steamroller16/lightpipe/README.md

lightpipe
=========
Test commit - Sam
Test commit - Adam!
