steamroller16/lightpipe/manufacturing/laser_cutter_file_rev2.pdf

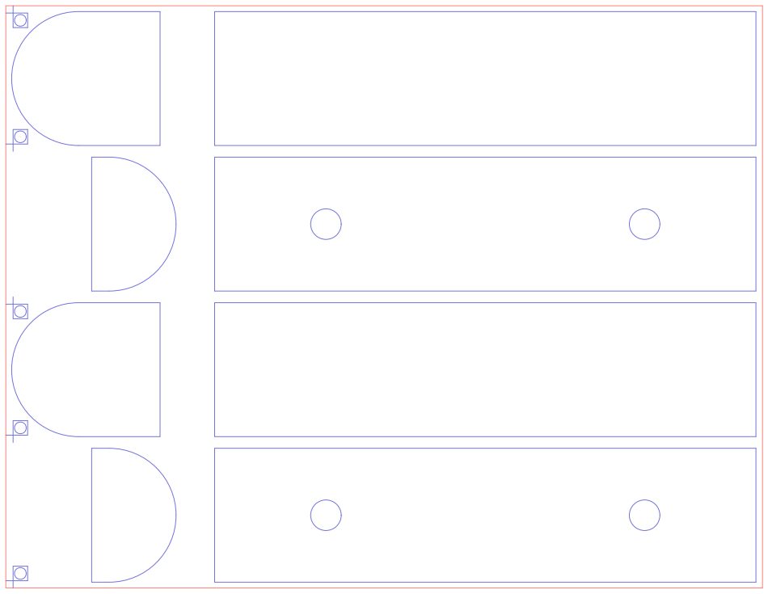
[picture p1: figure]
