steamroller16/lightpipe/assembly/assembly_merged_raster.pdf

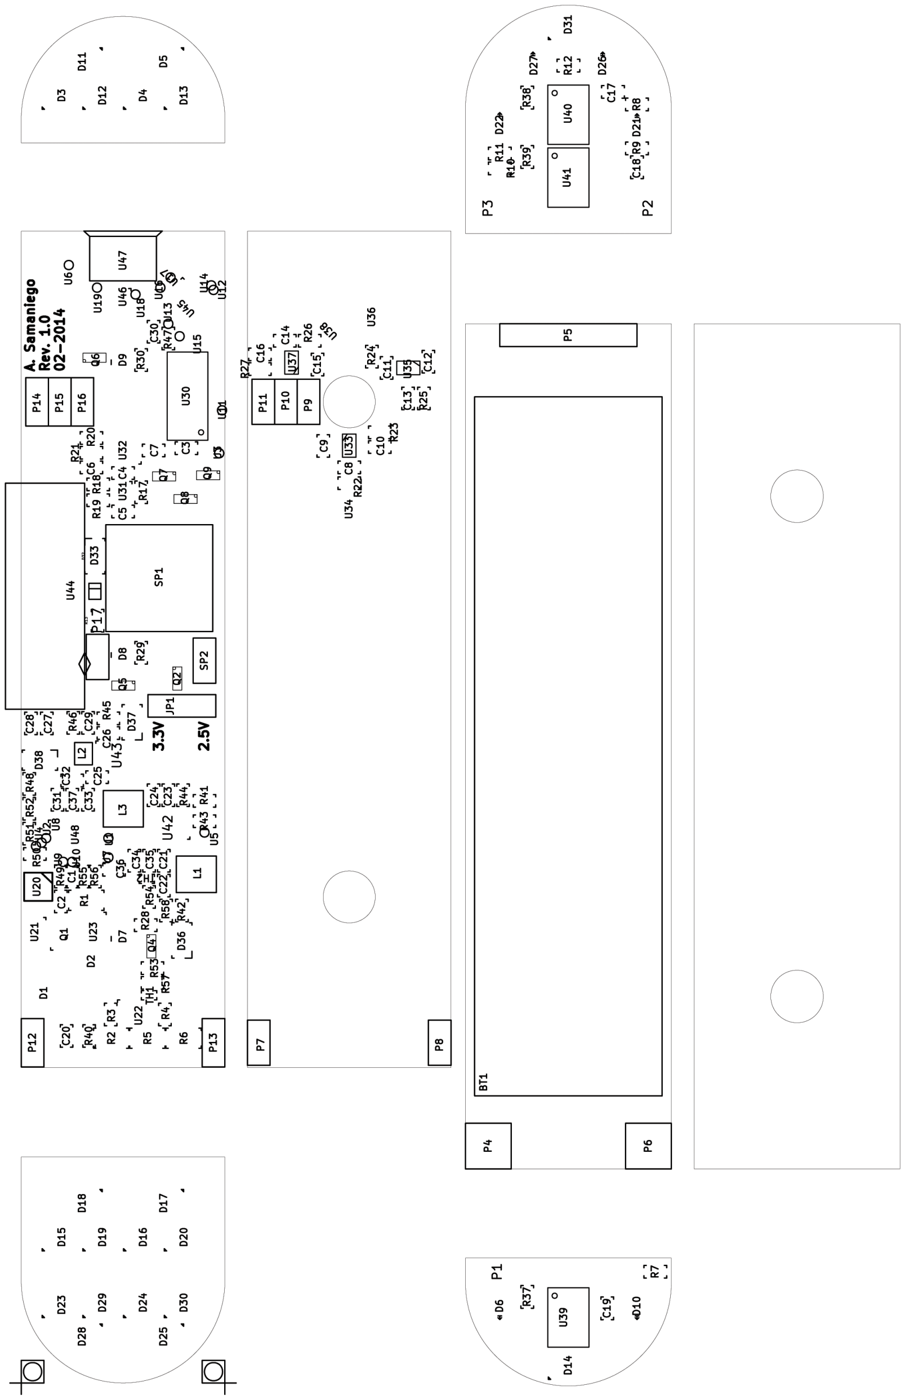
[picture p2: page 1]
