steamroller16/lightpipe/manufacturing/bike_light_PANEL_Laser_Cuts.pdf

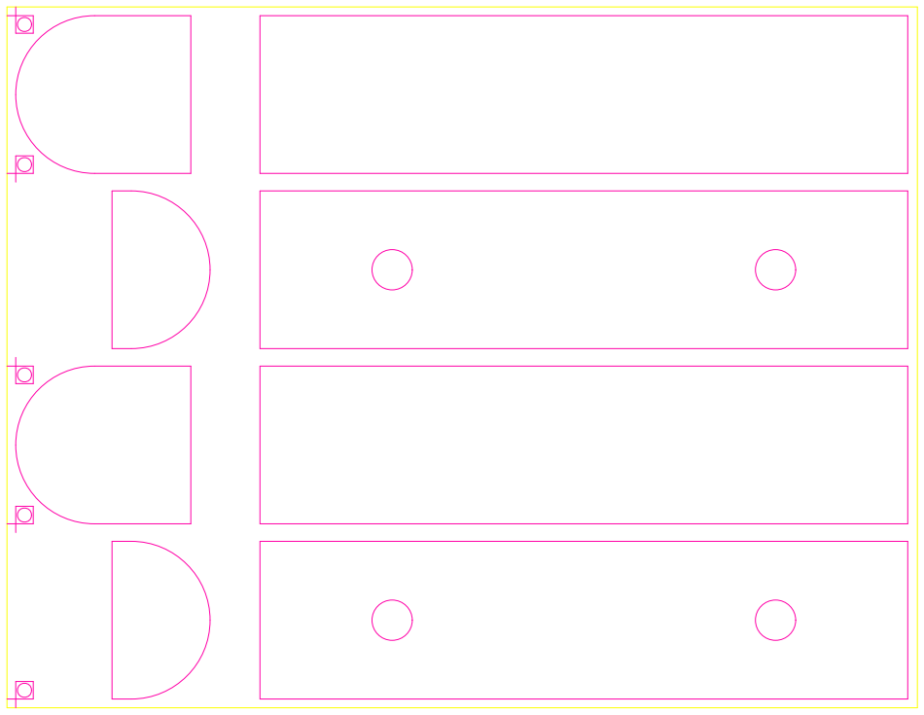
[picture p3: figure]
