steamroller16/lightpipe/manufacturing/preview_layer_1.png

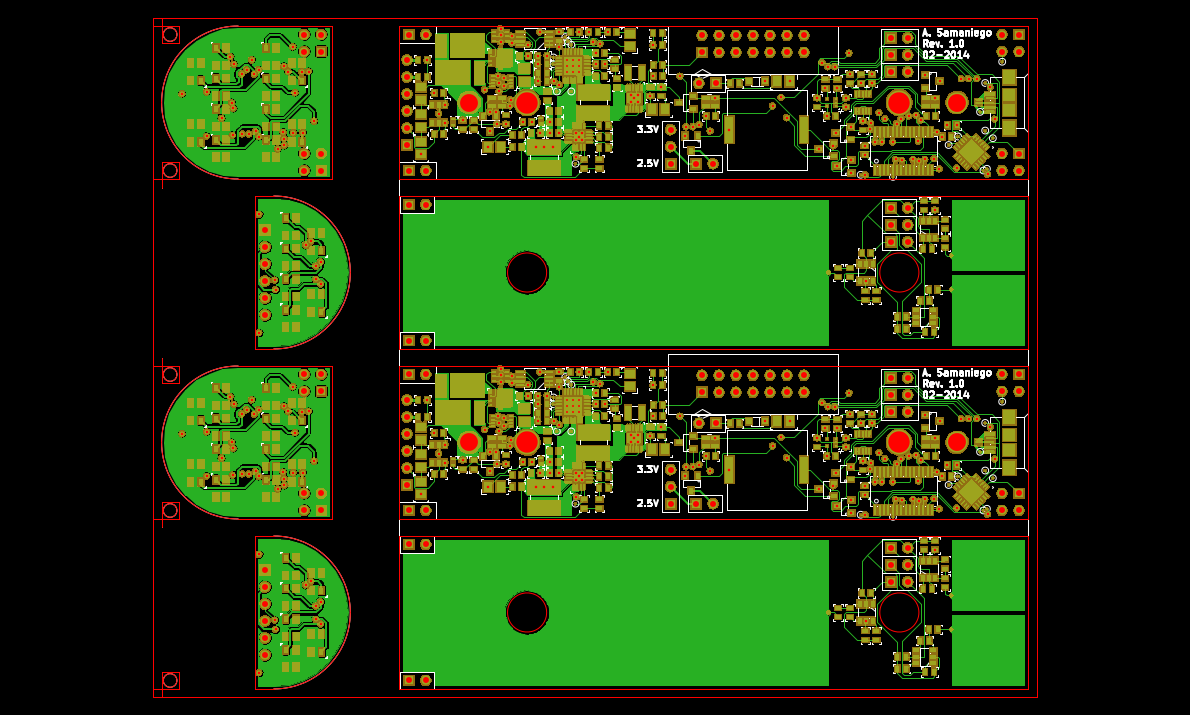
manufacturing/preview_layer_1.png
