steamroller16/lightpipe/manufacturing/preview_layer_2.png

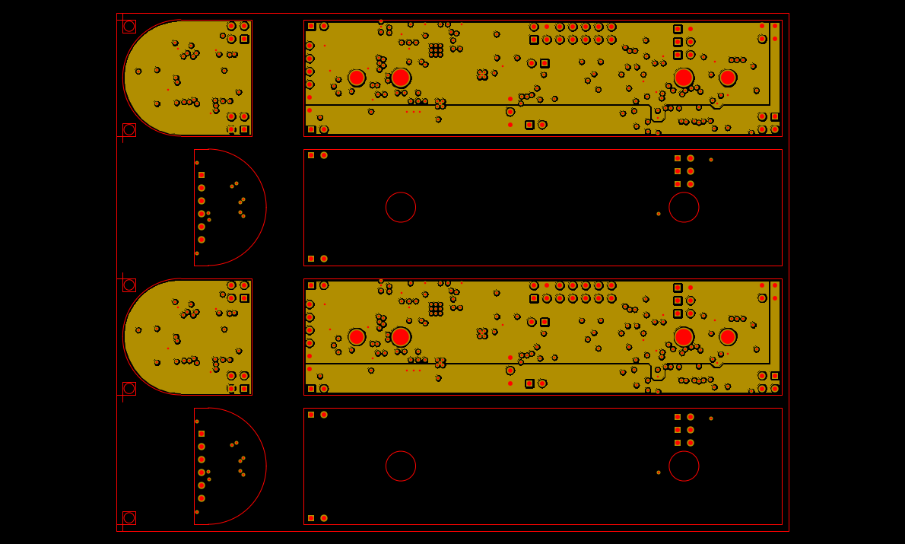
manufacturing/preview_layer_2.png
