steamroller16/lightpipe/manufacturing/preview_layer_3.png

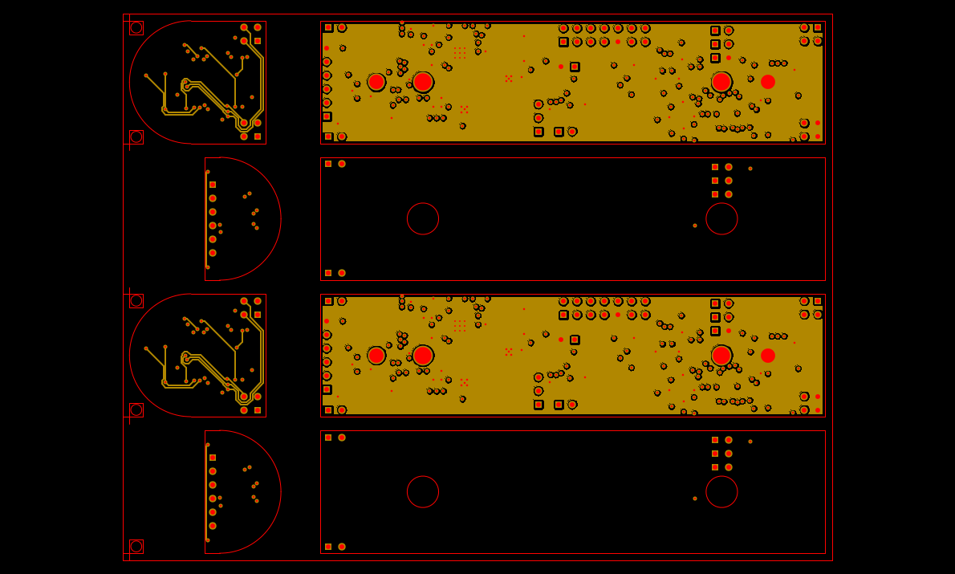
manufacturing/preview_layer_3.png
