steamroller16/lightpipe/manufacturing/preview_layer_4.png

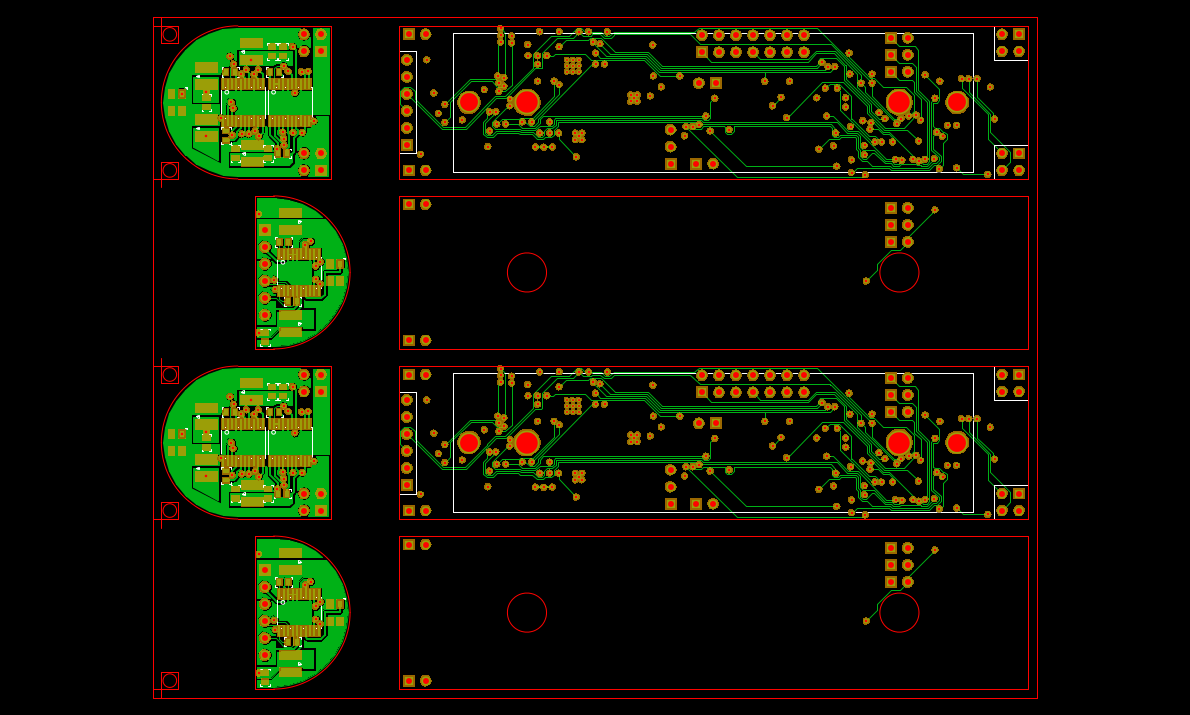
manufacturing/preview_layer_4.png
