steamroller16/lightpipe/assembly/bike_light_sch.pdf

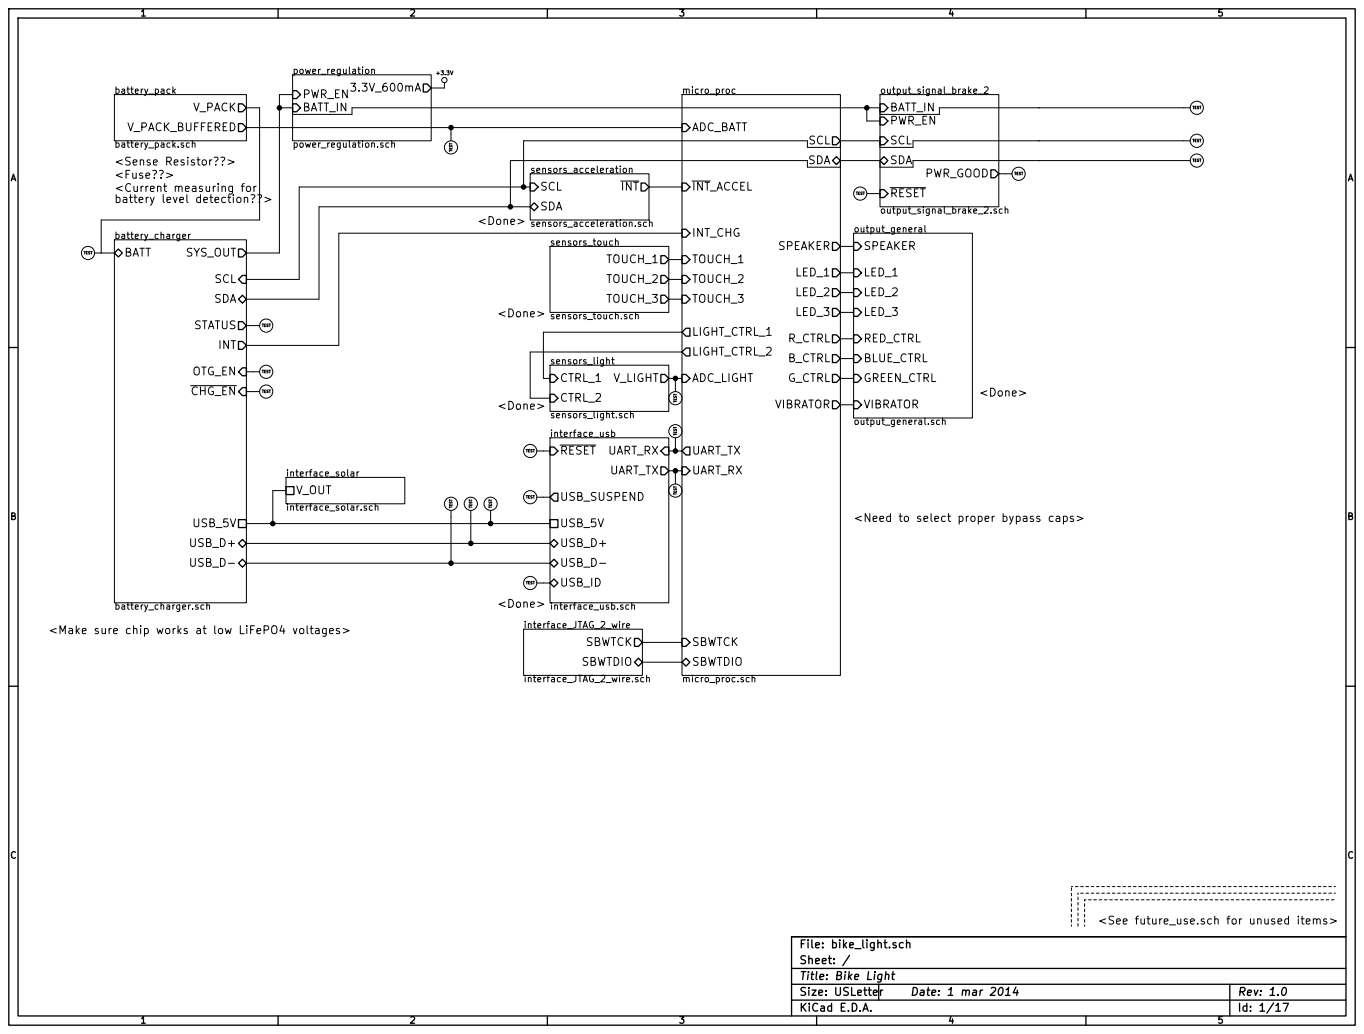
[picture p8: page 1]

<Need to select proper bypass caps>

<Make sure chip works at low LiFePO4 voltages>

<See future_use.sch for unused items>

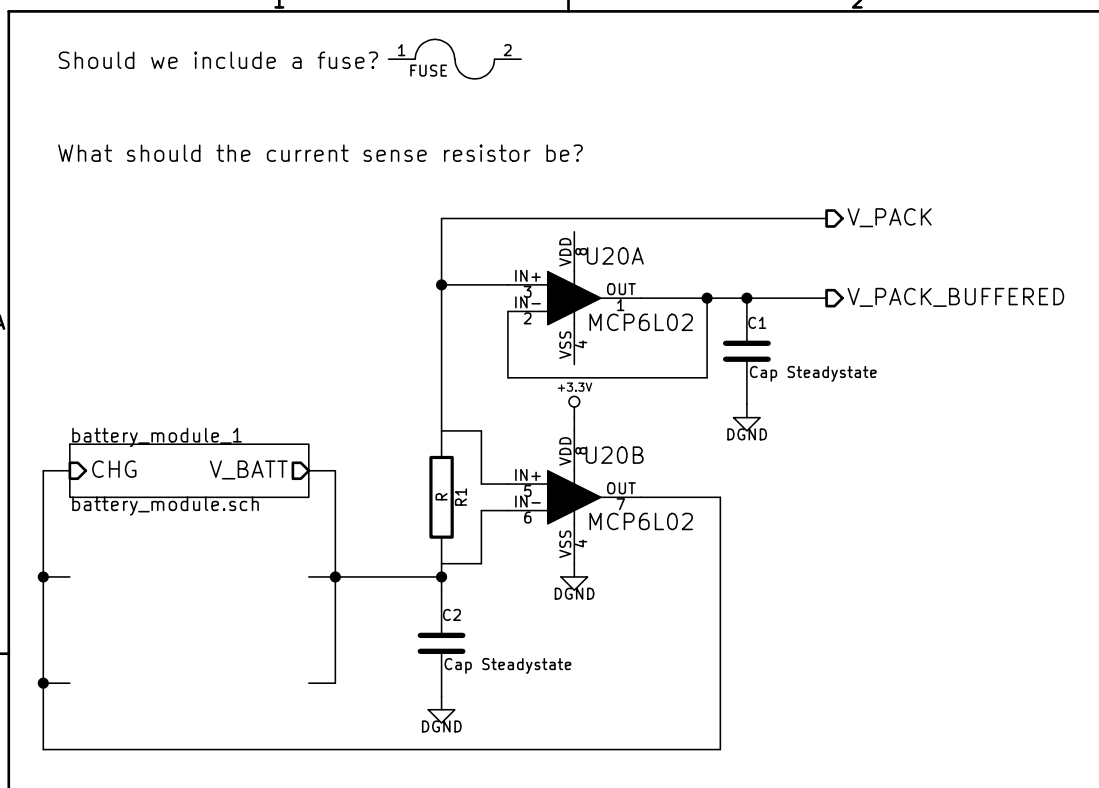
[picture p9: page 2]

Id: 2/17 Title: File: battery_pack.sch
Sheet: /battery_pack/

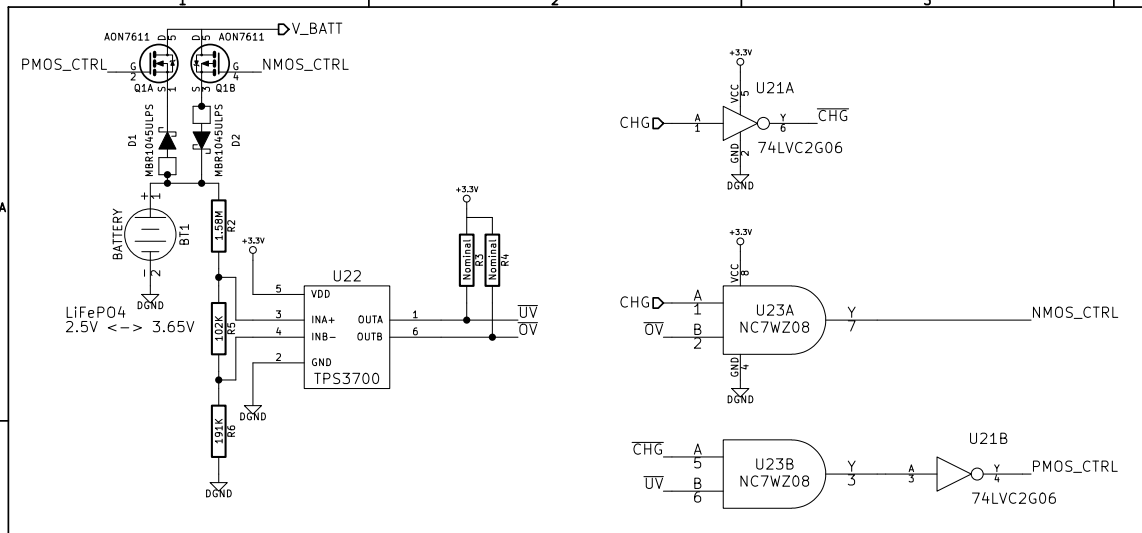
[picture p10: page 3]

Id: 3/17 Title: File: battery_module.sch
Sheet: /battery_pack/battery_module_1/

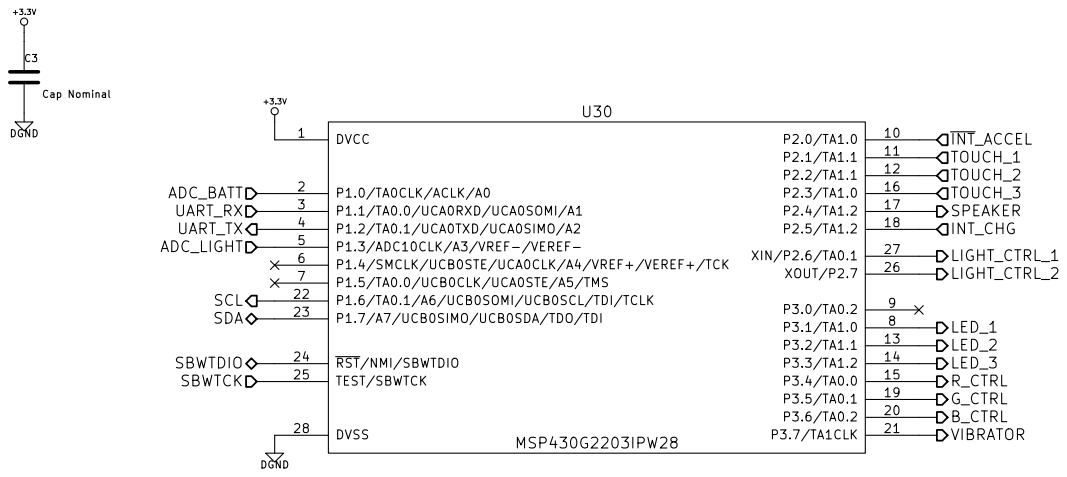
[picture p11: page 4]

Id: 4/17 Title: File: micro_proc.sch
Sheet: /micro_proc/

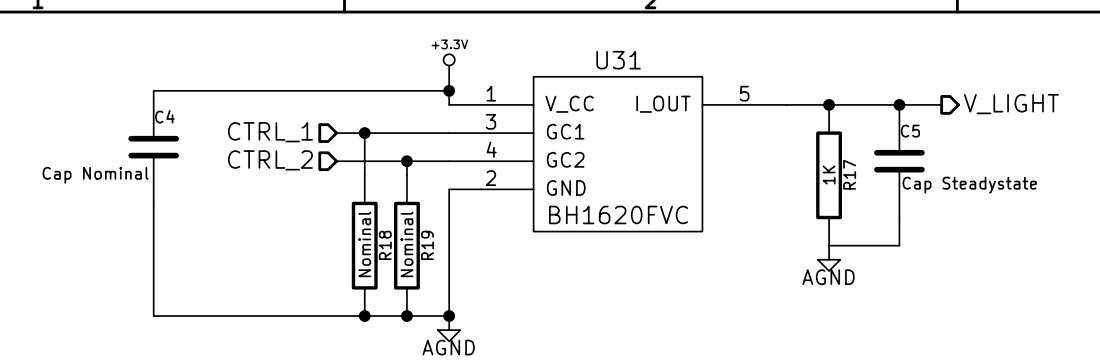
[picture p12: page 5]

Id: 5/17 Title: File: sensors_light.sch

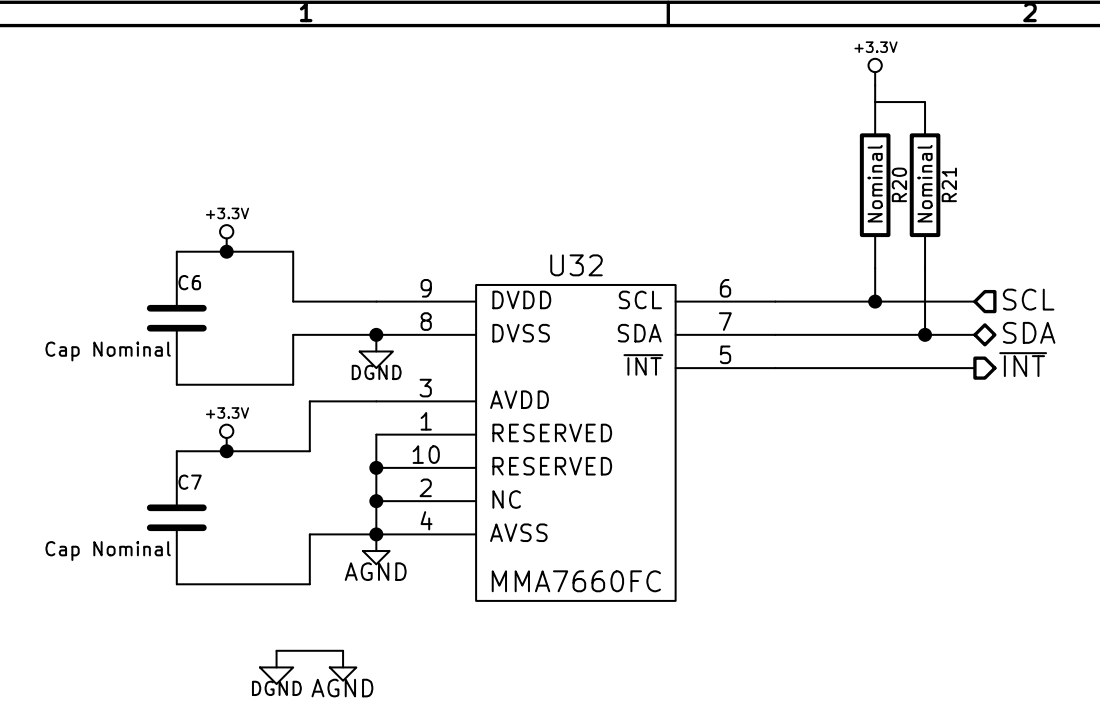
[picture p13: page 6]

Id: 6/17 Title: File: sensors_acceleration.sch
Sheet: /sensors_acceleration/

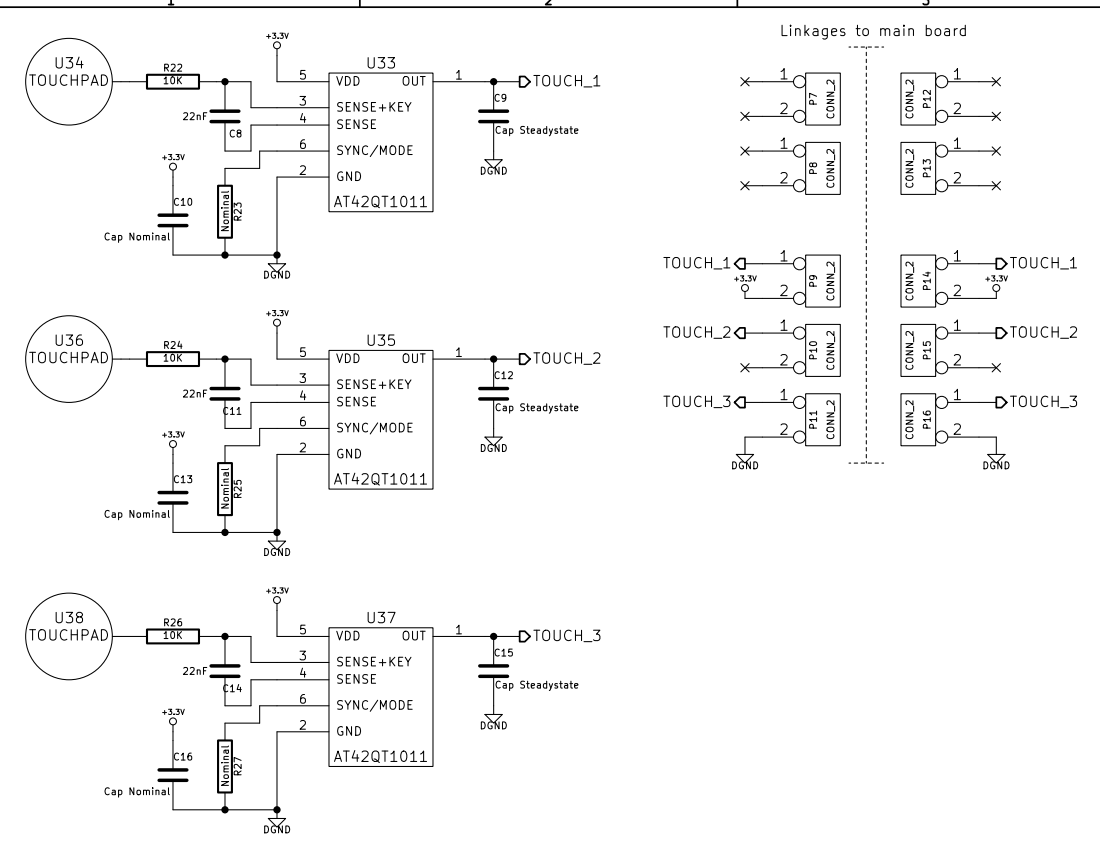
[picture p14: page 7]

Id: 7/17 Title: File: sensors_touch.sch
Sheet: /sensors_touch/

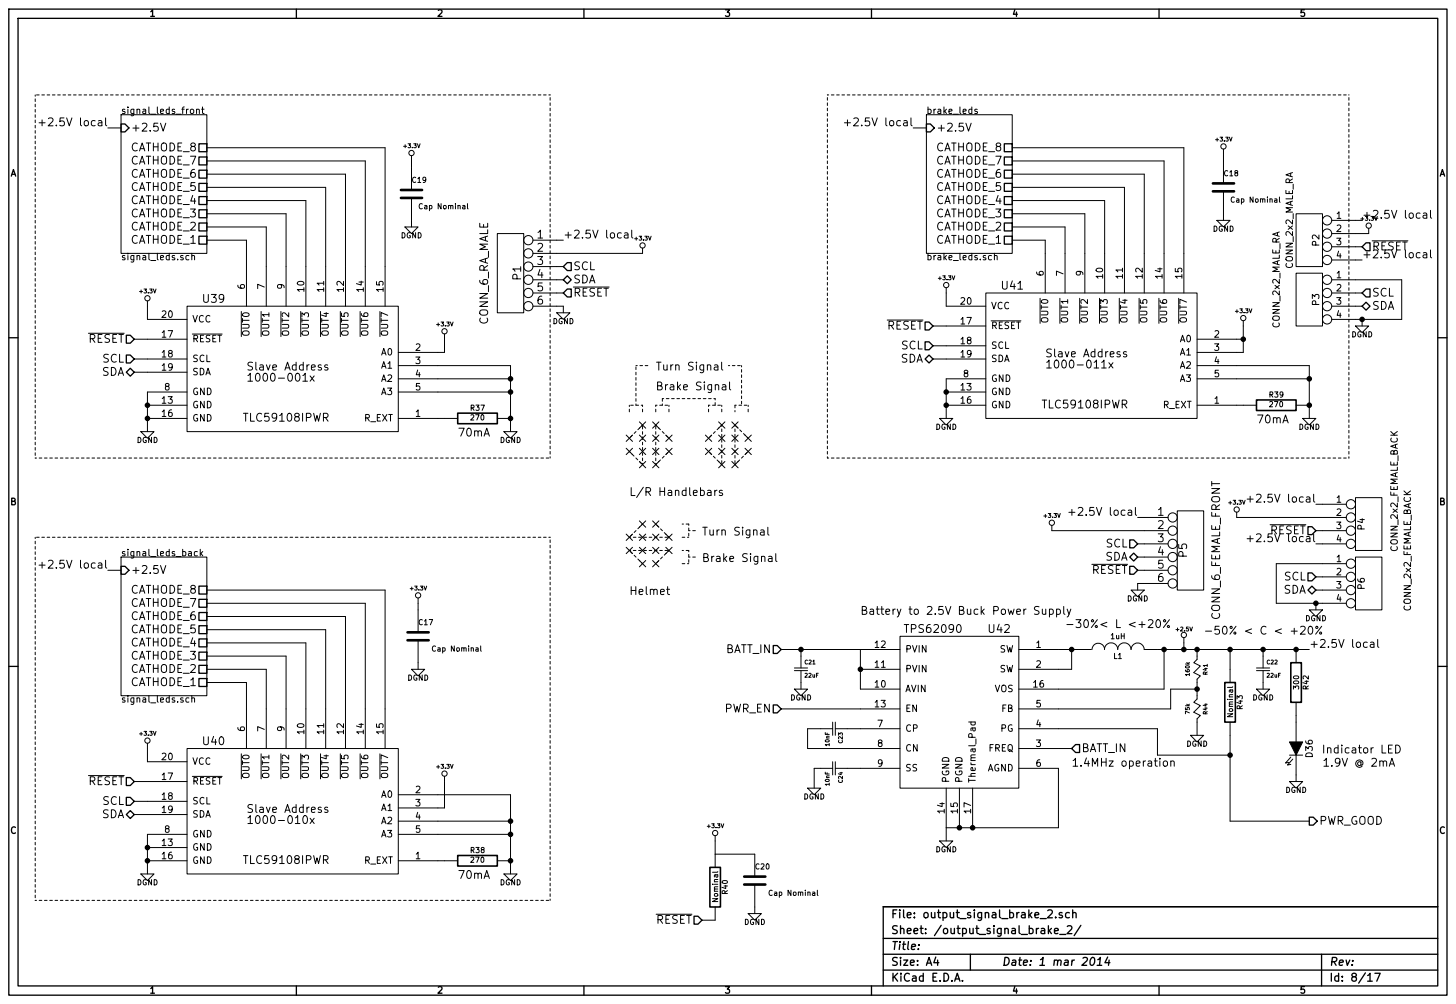
[picture p15: page 8]

9 OUT3 10 VCC 20 OUT4 11 OUT5 12 GND 13 OUT6 14 OUT7 15 GND 16 RESET 17 SCL 18 SDA 19 U41 TLC59108IPWR

9 OUT3 10 VCC 20 OUT4 11 OUT5 12 GND 13 OUT6 14 OUT7 15 GND 16 RESET 17 SCL 18 SDA 19 U39 TLC59108IPWR

+3.3VC17 Cap Nominal Slave Address 1000-010x RESET

9 OUT3 10 VCC 20 OUT4 11 OUT5 12 GND 13 OUT6 14 OUT7 15 GND 16 RESET 17 SCL 18 SDA 19 U40 TLC59108IPWR

Id: 8/17 Title: File: output_signal_brake_2.sch
Sheet: /output_signal_brake_2/

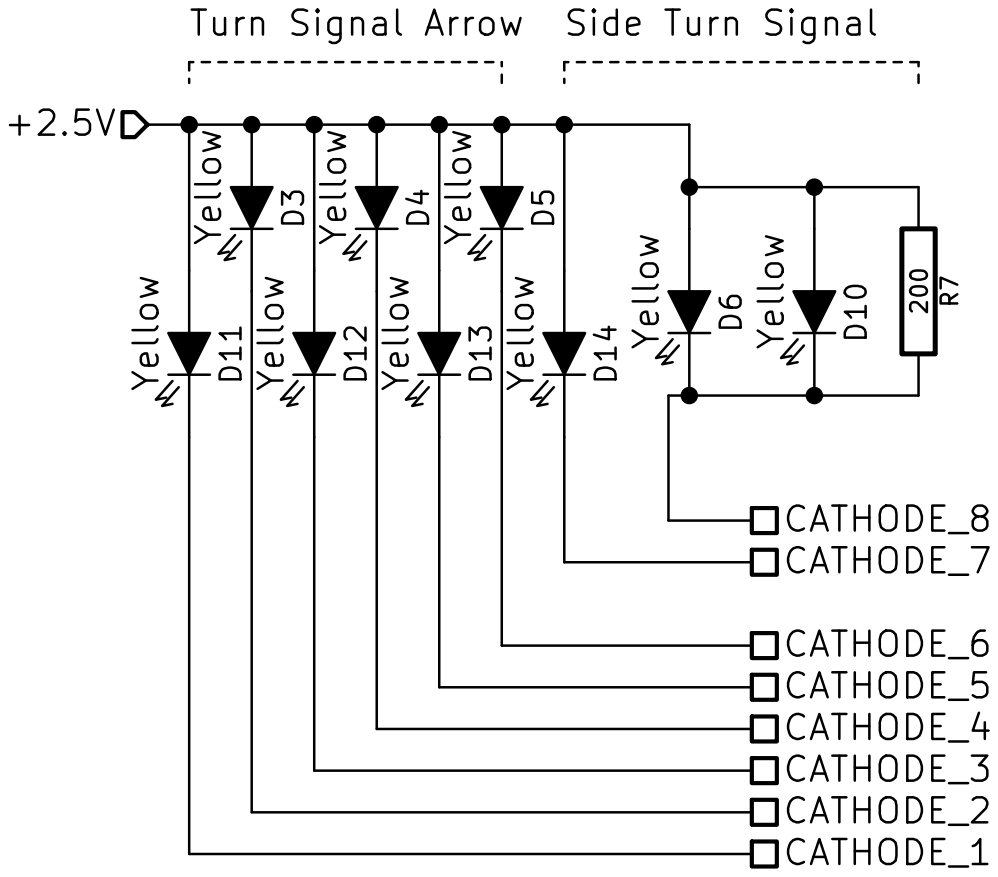
[picture p16: page 9]

Id: 9/17 Title: File: signal_leds.sch
Sheet: /output_signal_brake_2/signal_leds_front/

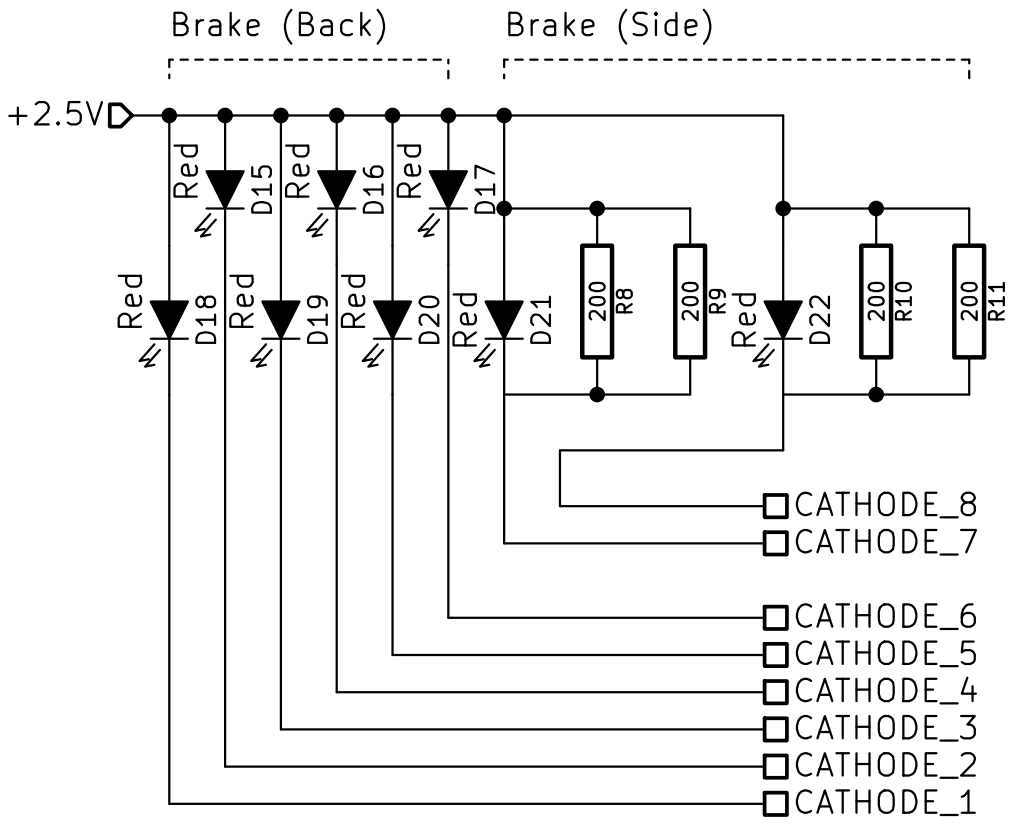
[picture p17: page 10]

Id: 10/17 Title: File: brake_leds.sch
Sheet: /output_signal_brake_2/brake_leds/

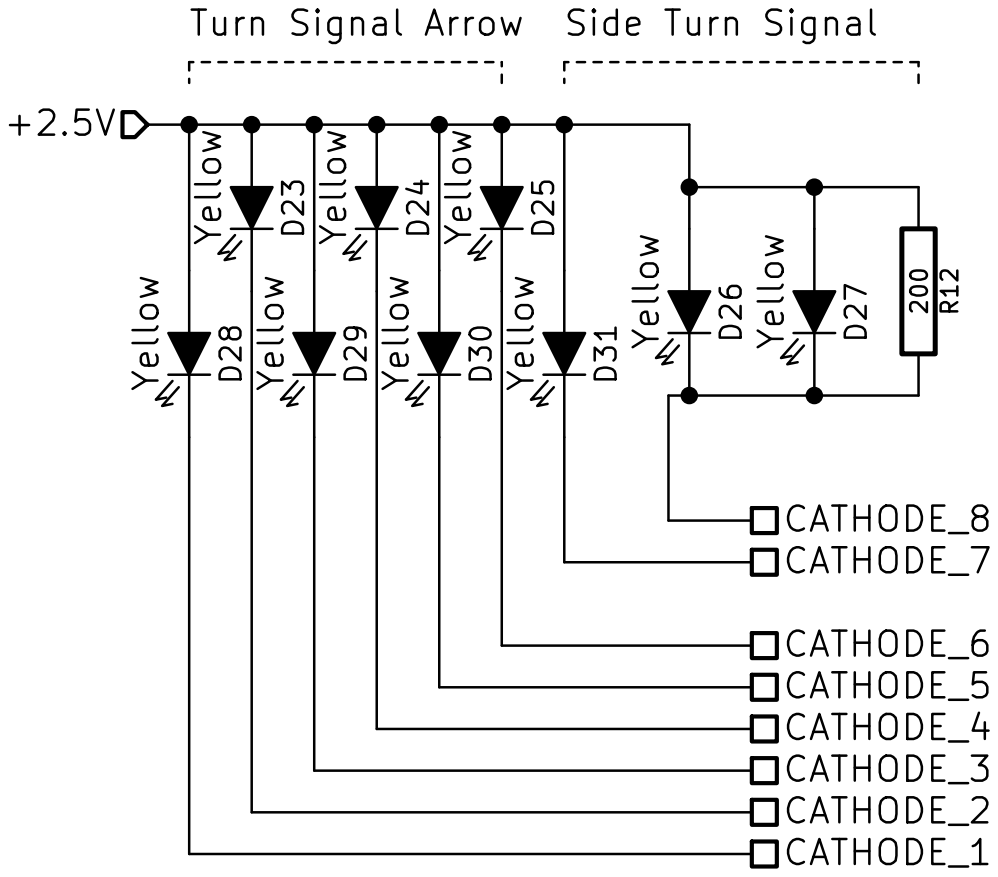
[picture p18: page 11]

Id: 11/17 Title: File: signal_leds.sch
Sheet: /output_signal_brake_2/signal_leds_back/

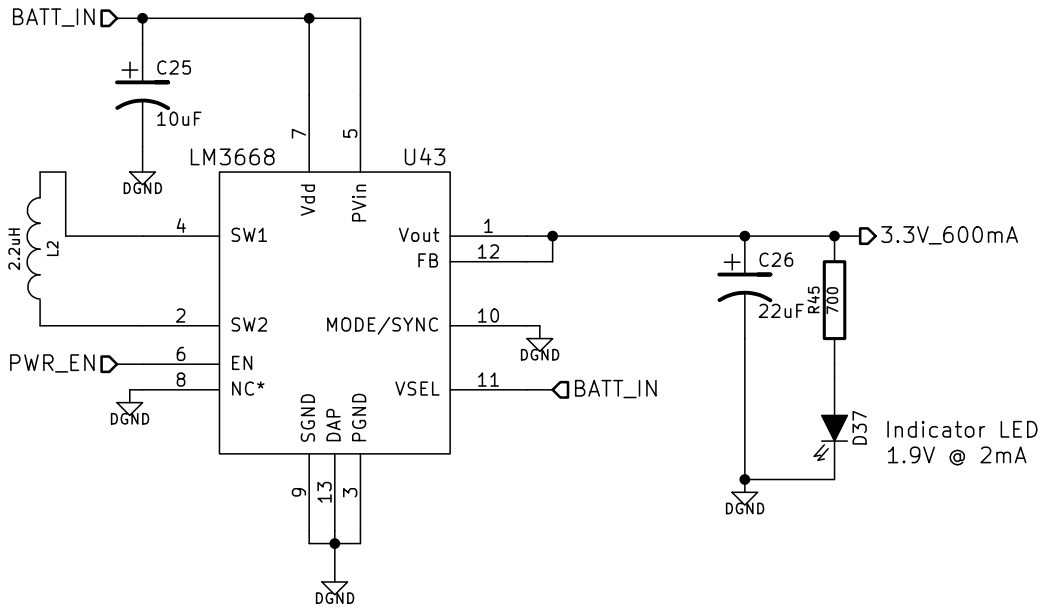
[picture p19: page 12]

9 MODE/SYNC 10 VSEL 11 FB 12 DAP 13 LM3668 U43 + C25

Id: 12/17 Title: File: power_regulation.sch

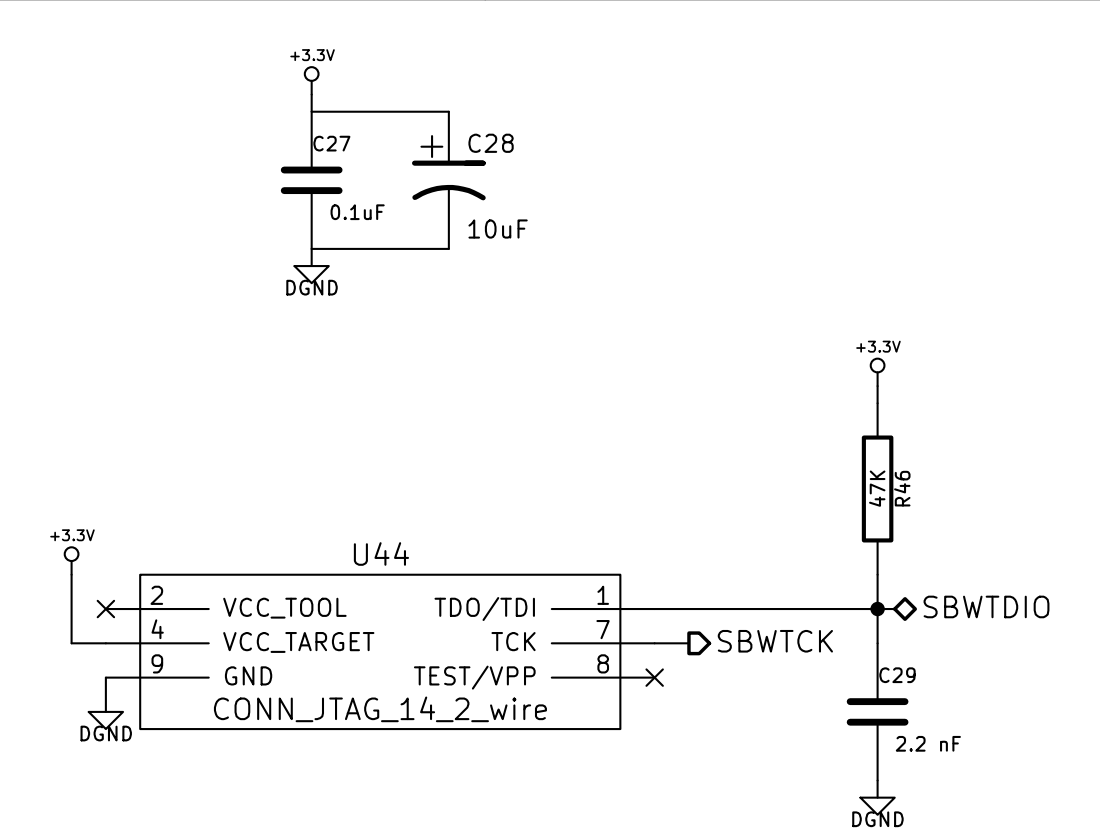
[picture p20: page 13]

Id: 13/17 Title: File: interface_JTAG_2_wire.sch
Sheet: /interface_JTAG_2_wire/

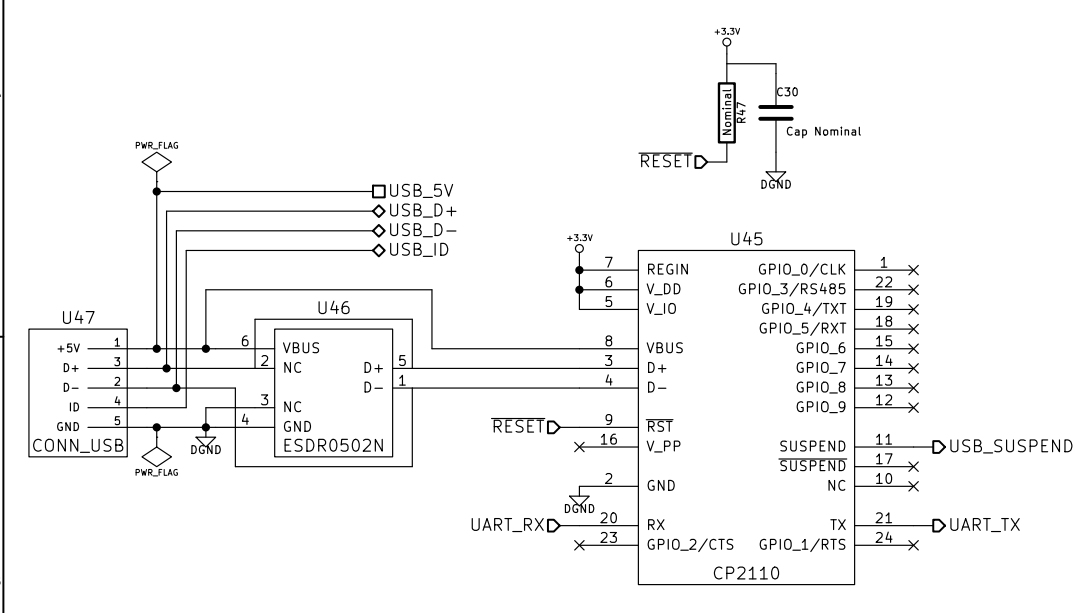
[picture p21: page 14]

Id: 14/17 Title: File: interface_usb.sch
Sheet: /interface_usb/

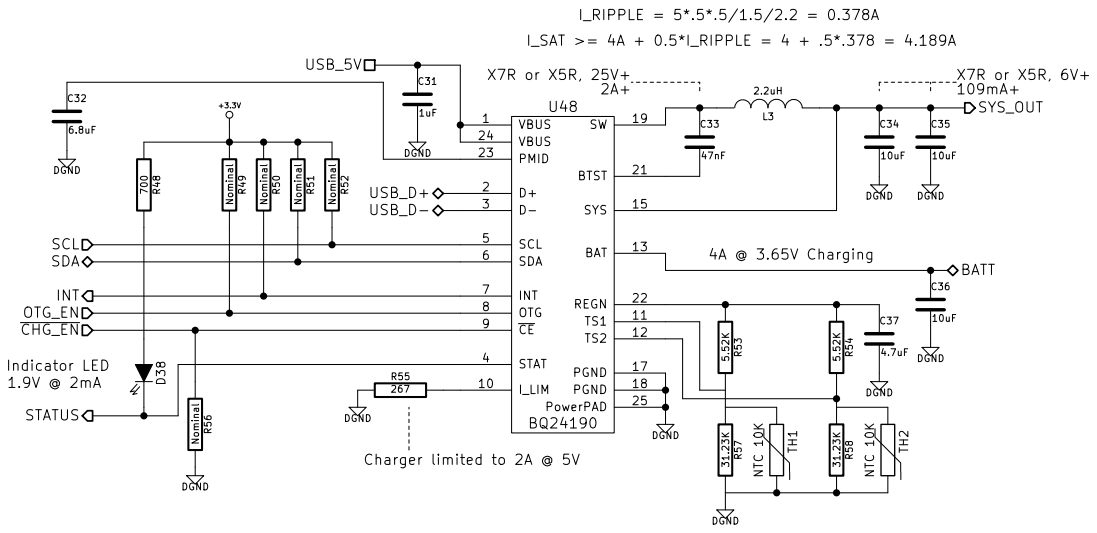
[picture p22: page 15]

Id: 15/17 Title: File: battery_charger.sch
Sheet: /battery_charger/

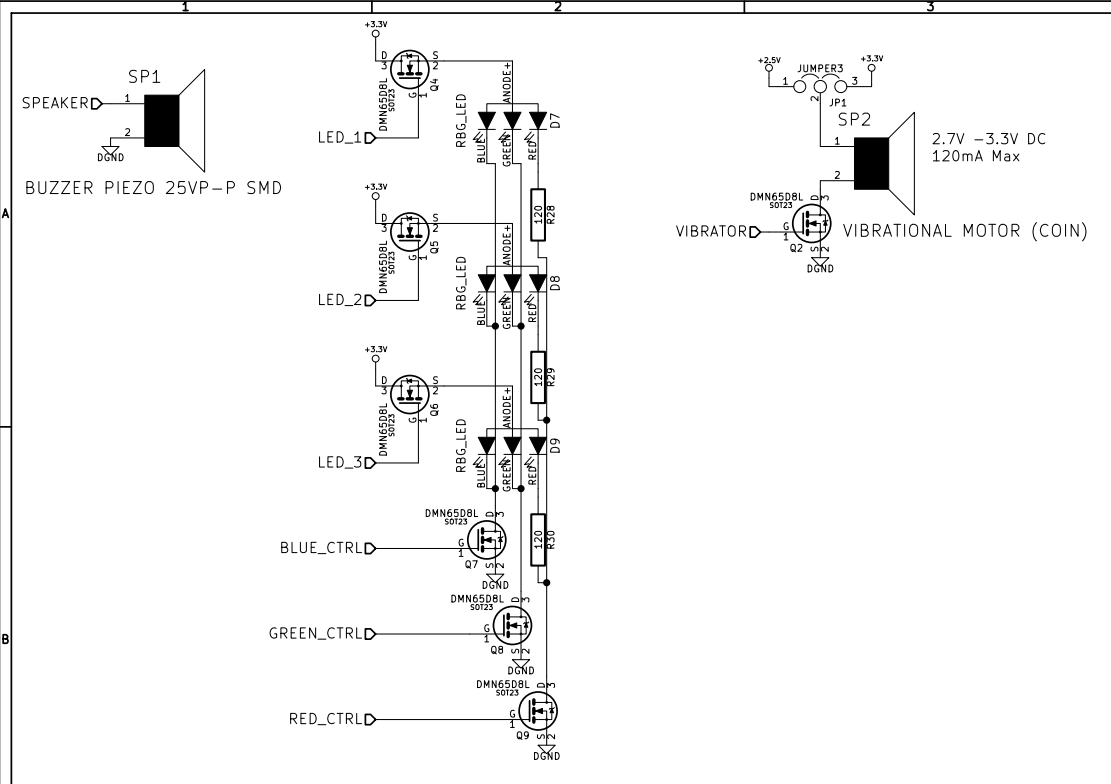
[picture p23: page 16]

3 Q2 DMN65D8L
VIBRATIONAL MOTOR (COIN) DGND

Id: 16/17 Title: File: output_general.sch
Sheet: /output_general/

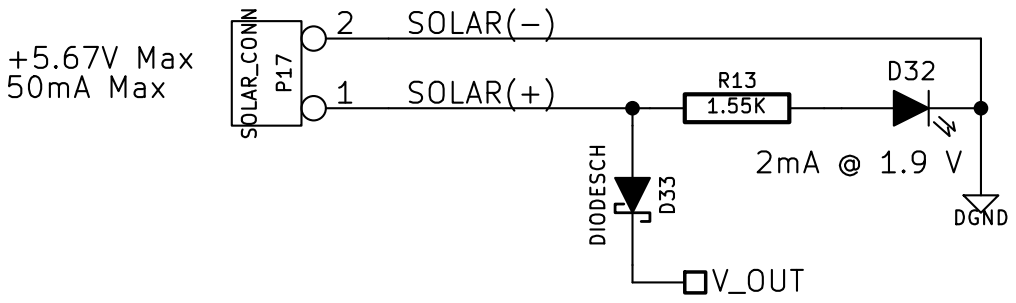
[picture p24: page 17]

Id: 17/17 Title: File: interface_solar.sch
Sheet: /interface_solar/
