steamroller16/lightpipe/assembly/assembly_bottom_vector.pdf

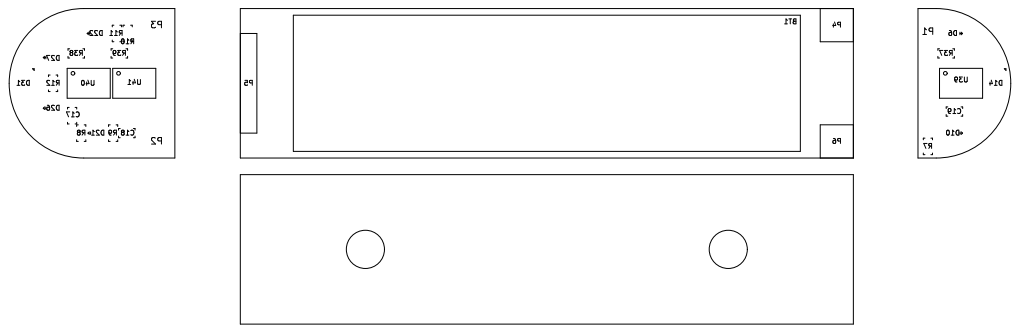
[picture p25: page 1]
