steamroller16/lightpipe/assembly/assembly_top_vector.pdf

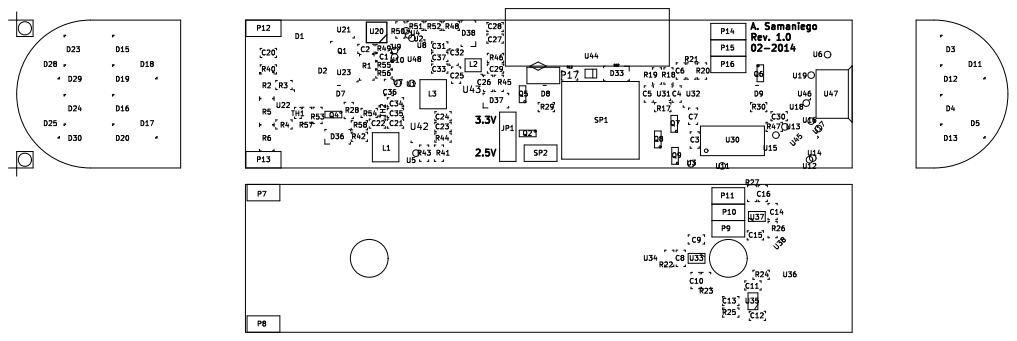
[picture p26: page 1]
