steamroller16/lightpipe/(list of files, drawings)

Other design files:
bike_light.dsn
