steamroller16/lightpipe/bike_light.kicad_pcb

## KiCad design bike_light.kicad_pcb (2014-06-01)

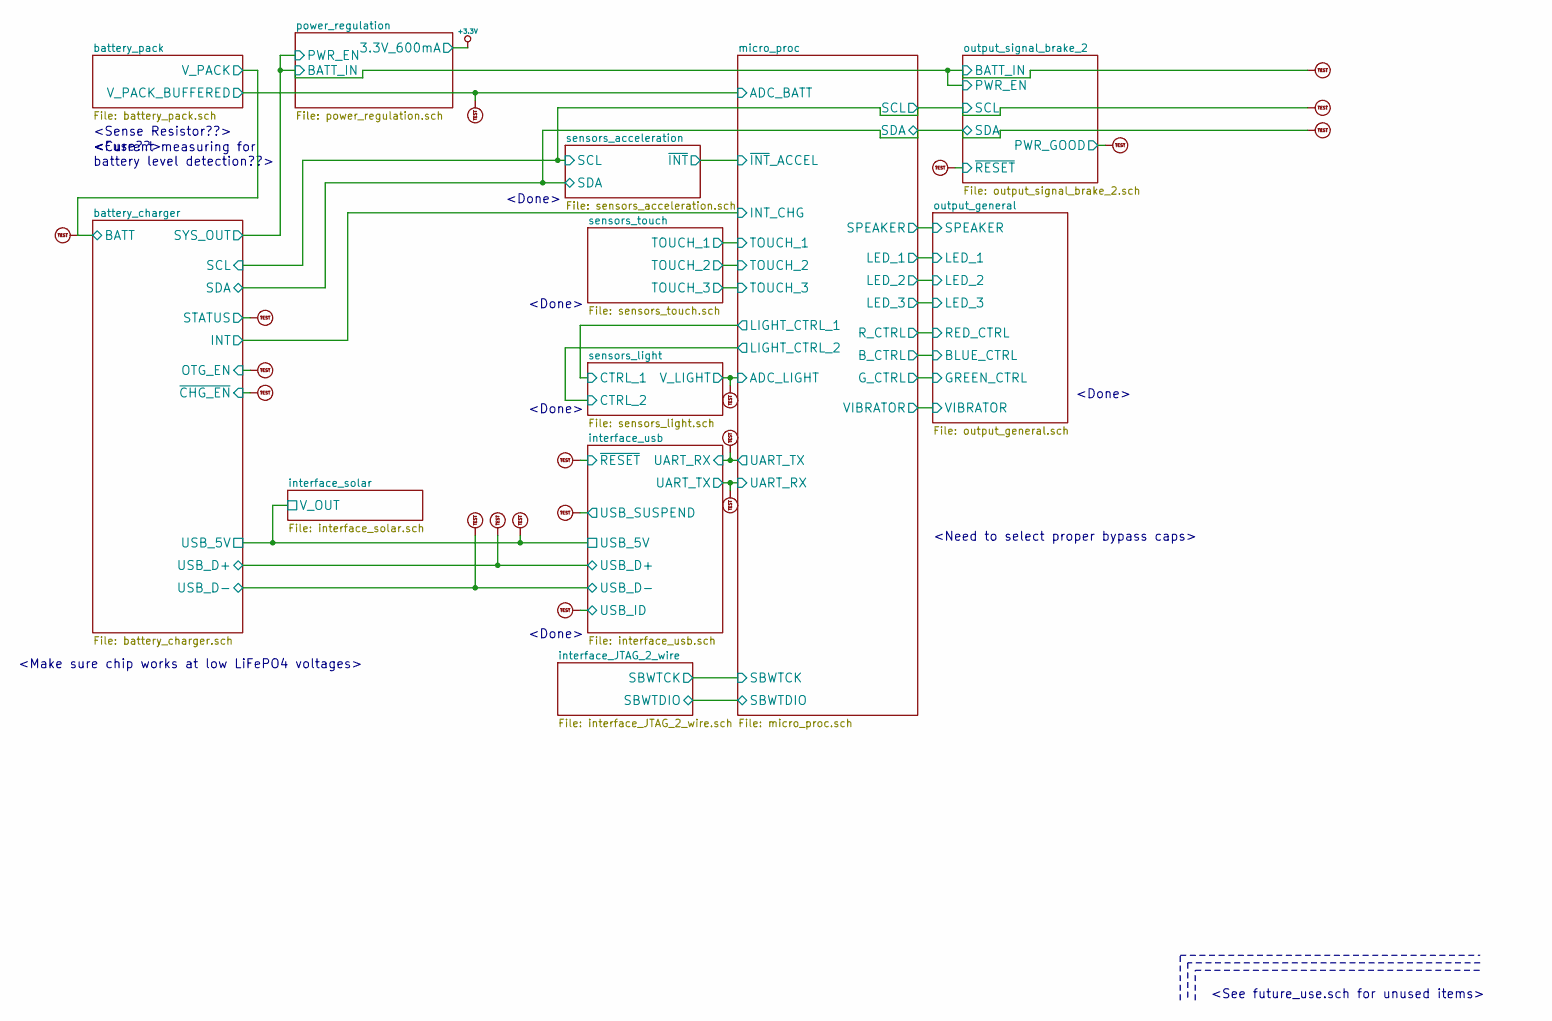
[picture p27: schematic bike_light.sch, Bike Light]

Parts:
U1, U2, U3, U4, U5, U6, U7, U8, U9, U10, U11, U12, U13, U14, U15, U16, U17, U18, U19: TEST_PT

Connections:
/battery_charger/BATT: U7.1; also elsewhere on the board
/battery_charger/OTG_EN: U9.1; also elsewhere on the board
/battery_charger/SCL: U2.1; also elsewhere on the board
/battery_charger/SDA: U4.1; also elsewhere on the board
/battery_charger/STATUS: U8.1; also elsewhere on the board
/battery_charger/USB_5V: U18.1; also elsewhere on the board
/battery_charger/USB_D+: U17.1; also elsewhere on the board
/battery_charger/USB_D-: U16.1; also elsewhere on the board
/battery_charger/~CHG_EN: U10.1; also elsewhere on the board
/interface_usb/UART_RX: U12.1; also elsewhere on the board
/interface_usb/USB_ID: U19.1; also elsewhere on the board
/interface_usb/USB_SUSPEND: U15.1; also elsewhere on the board
/interface_usb/~RESET: U13.1; also elsewhere on the board
/micro_proc/ADC_BATT: U3.1; also elsewhere on the board
/micro_proc/ADC_LIGHT: U11.1; also elsewhere on the board
/micro_proc/UART_RX: U14.1; also elsewhere on the board
/output_signal_brake_2/BATT_IN: U1.1; also elsewhere on the board
/output_signal_brake_2/PWR_GOOD: U5.1; also elsewhere on the board
/output_signal_brake_2/~RESET: U6.1; also elsewhere on the board

Notes on the sheet:
<Done>
<Sense Resistor??>
<Fuse??>
<Current measuring for battery level detection??>
<Make sure chip works at low LiFePO4 voltages>
<See future_use.sch for unused items>
<Need to select proper bypass caps>

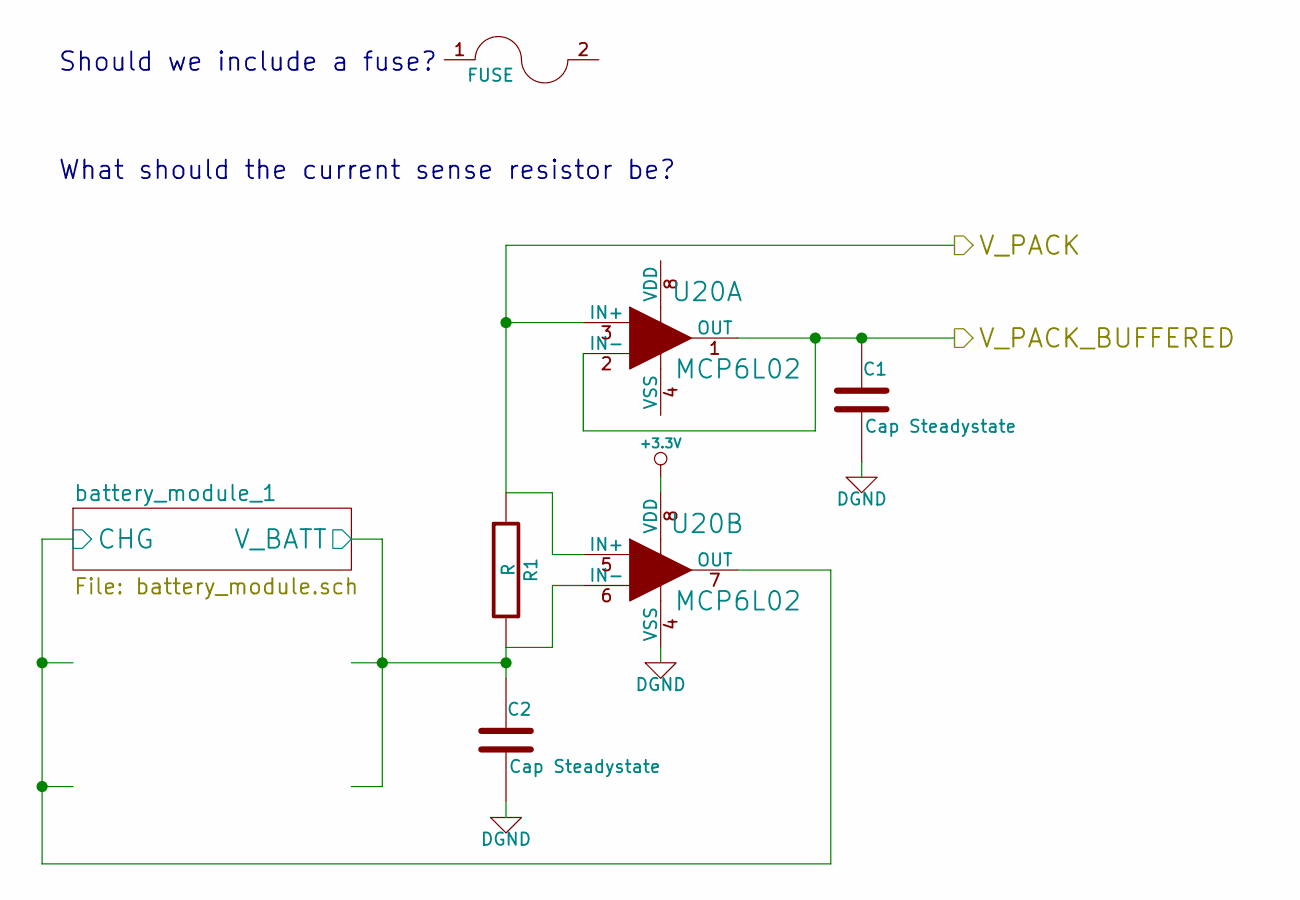
[picture p28: schematic battery_pack.sch]

Parts:
C1, C2: Cap Steadystate
R1: R
U20: MCP6L02

Connections:
+3.3V: U20.8 (VDD); also elsewhere on the board
/battery_charger/BATT: R1.1, U20.3 (IN+), U20.5 (IN+); also elsewhere on the board
/battery_pack/battery_module_1/CHG: U20.7 (OUT); also elsewhere on the board
/battery_pack/battery_module_1/V_BATT: C2.1, R1.2, U20.6 (IN-); also elsewhere on the board
/micro_proc/ADC_BATT: C1.1, U20.1 (OUT), U20.2 (IN-); also elsewhere on the board
AGND: C1.2, C2.2, U20.4 (VSS); also elsewhere on the board

Notes on the sheet:
Should we include a fuse?
What should the current sense resistor be?

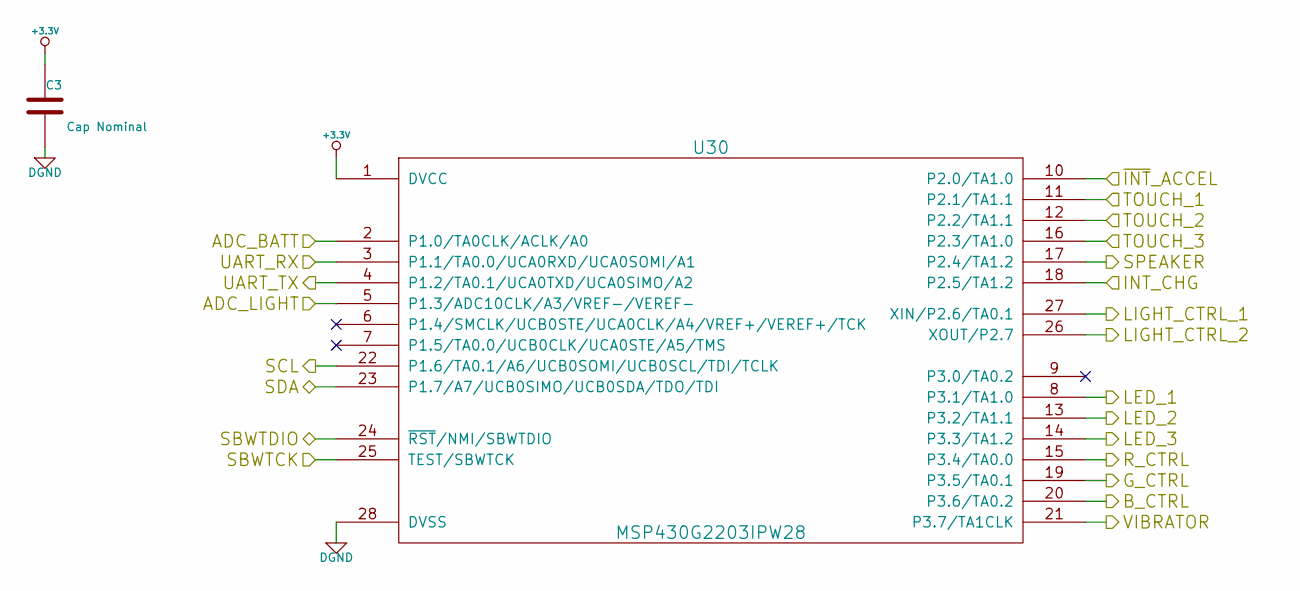
[picture p29: schematic micro_proc.sch]

Parts:
C3: Cap Nominal
U30: MSP430G2203IPW28

Connections:
+3.3V: C3.1, U30.1 (DVCC); also elsewhere on the board
/battery_charger/INT: U30.18 (P2.5/TA1.2); also elsewhere on the board
/battery_charger/SCL: U30.22 (P1.6/TA0.1/A6/UCB0SOMI/UCB0SCL/TDI/TCLK); also elsewhere on the board
/battery_charger/SDA: U30.23 (P1.7/A7/UCB0SIMO/UCB0SDA/TDO/TDI); also elsewhere on the board
/interface_JTAG_2_wire/SBWTCK: U30.25 (TEST/SBWTCK); also elsewhere on the board
/interface_JTAG_2_wire/SBWTDIO: U30.24 (~RST~/NMI/SBWTDIO); also elsewhere on the board
/interface_usb/UART_RX: U30.4 (P1.2/TA0.1/UCA0TXD/UCA0SIMO/A2); also elsewhere on the board
/micro_proc/ADC_BATT: U30.2 (P1.0/TA0CLK/ACLK/A0); also elsewhere on the board
/micro_proc/ADC_LIGHT: U30.5 (P1.3/ADC10CLK/A3/VREF-/VEREF-); also elsewhere on the board
/micro_proc/LED_1: U30.8 (P3.1/TA1.0); also elsewhere on the board
/micro_proc/LED_2: U30.13 (P3.2/TA1.1); also elsewhere on the board
/micro_proc/LED_3: U30.14 (P3.3/TA1.2); also elsewhere on the board
/micro_proc/SPEAKER: U30.17 (P2.4/TA1.2); also elsewhere on the board
/micro_proc/TOUCH_1: U30.11 (P2.1/TA1.1); also elsewhere on the board
/micro_proc/TOUCH_2: U30.12 (P2.2/TA1.1); also elsewhere on the board
/micro_proc/TOUCH_3: U30.16 (P2.3/TA1.0); also elsewhere on the board
/micro_proc/UART_RX: U30.3 (P1.1/TA0.0/UCA0RXD/UCA0SOMI/A1); also elsewhere on the board
/micro_proc/VIBRATOR: U30.21 (P3.7/TA1CLK); also elsewhere on the board
/output_general/BLUE_CTRL: U30.20 (P3.6/TA0.2); also elsewhere on the board
/output_general/GREEN_CTRL: U30.19 (P3.5/TA0.1); also elsewhere on the board
/output_general/RED_CTRL: U30.15 (P3.4/TA0.0); also elsewhere on the board
/sensors_acceleration/~INT: U30.10 (P2.0/TA1.0); also elsewhere on the board
/sensors_light/CTRL_1: U30.27 (XIN/P2.6/TA0.1); also elsewhere on the board
/sensors_light/CTRL_2: U30.26 (XOUT/P2.7); also elsewhere on the board
AGND: C3.2, U30.28 (DVSS); also elsewhere on the board

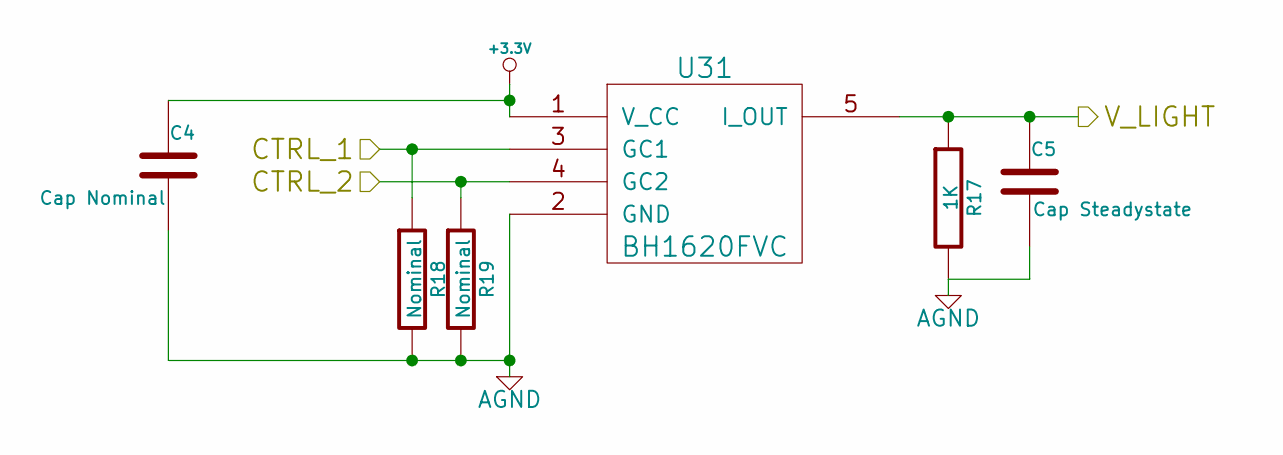
[picture p30: schematic sensors_light.sch]

Parts:
C4: Cap Nominal
C5: Cap Steadystate
R17: 1K
R18, R19: Nominal
U31: BH1620FVC

Connections:
+3.3V: C4.1, U31.1 (V_CC); also elsewhere on the board
/micro_proc/ADC_LIGHT: C5.1, R17.1, U31.5 (I_OUT); also elsewhere on the board
/sensors_light/CTRL_1: R18.1, U31.3 (GC1); also elsewhere on the board
/sensors_light/CTRL_2: R19.1, U31.4 (GC2); also elsewhere on the board
AGND: C4.2, C5.2, R17.2, R18.2, R19.2, U31.2 (GND); also elsewhere on the board

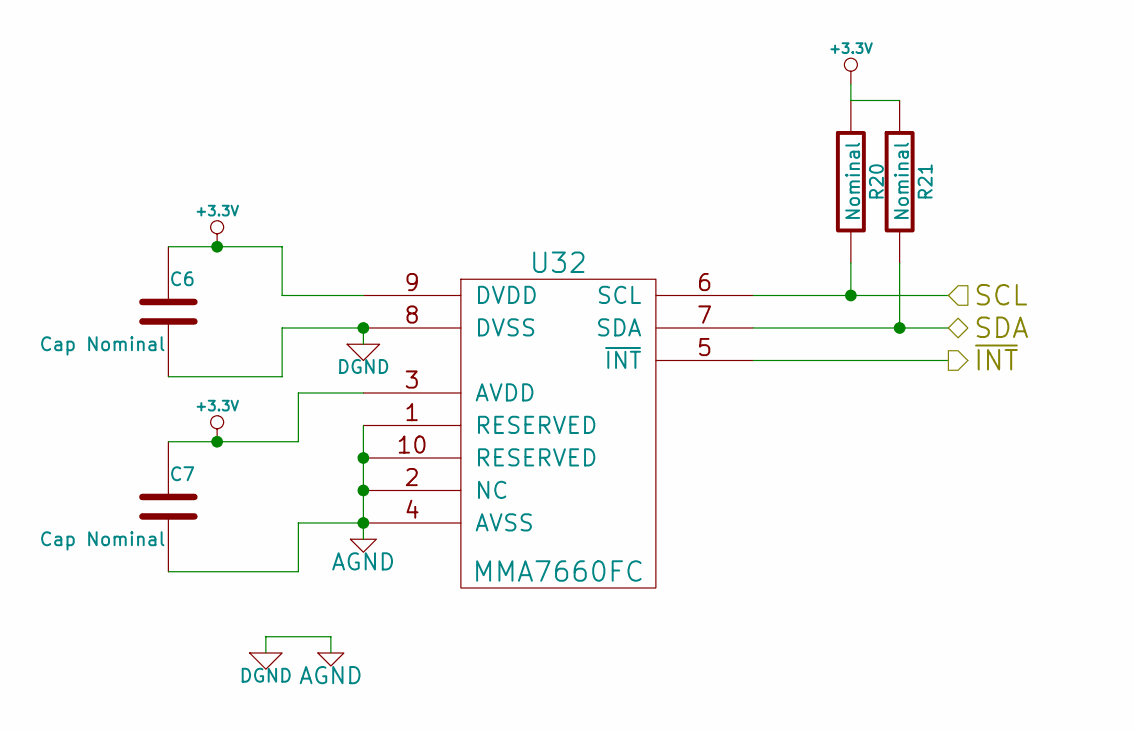
[picture p31: schematic sensors_acceleration.sch]

Parts:
C6, C7: Cap Nominal
R20, R21: Nominal
U32: MMA7660FC

Connections:
+3.3V: C6.1, C7.1, R20.1, R21.1, U32.3 (AVDD), U32.9 (DVDD); also elsewhere on the board
/battery_charger/SCL: R20.2, U32.6 (SCL); also elsewhere on the board
/battery_charger/SDA: R21.2, U32.7 (SDA); also elsewhere on the board
/sensors_acceleration/~INT: U32.5 (~INT); also elsewhere on the board
AGND: C6.2, C7.2, U32.1 (RESERVED), U32.2 (NC), U32.4 (AVSS), U32.8 (DVSS), U32.10 (RESERVED); also elsewhere on the board

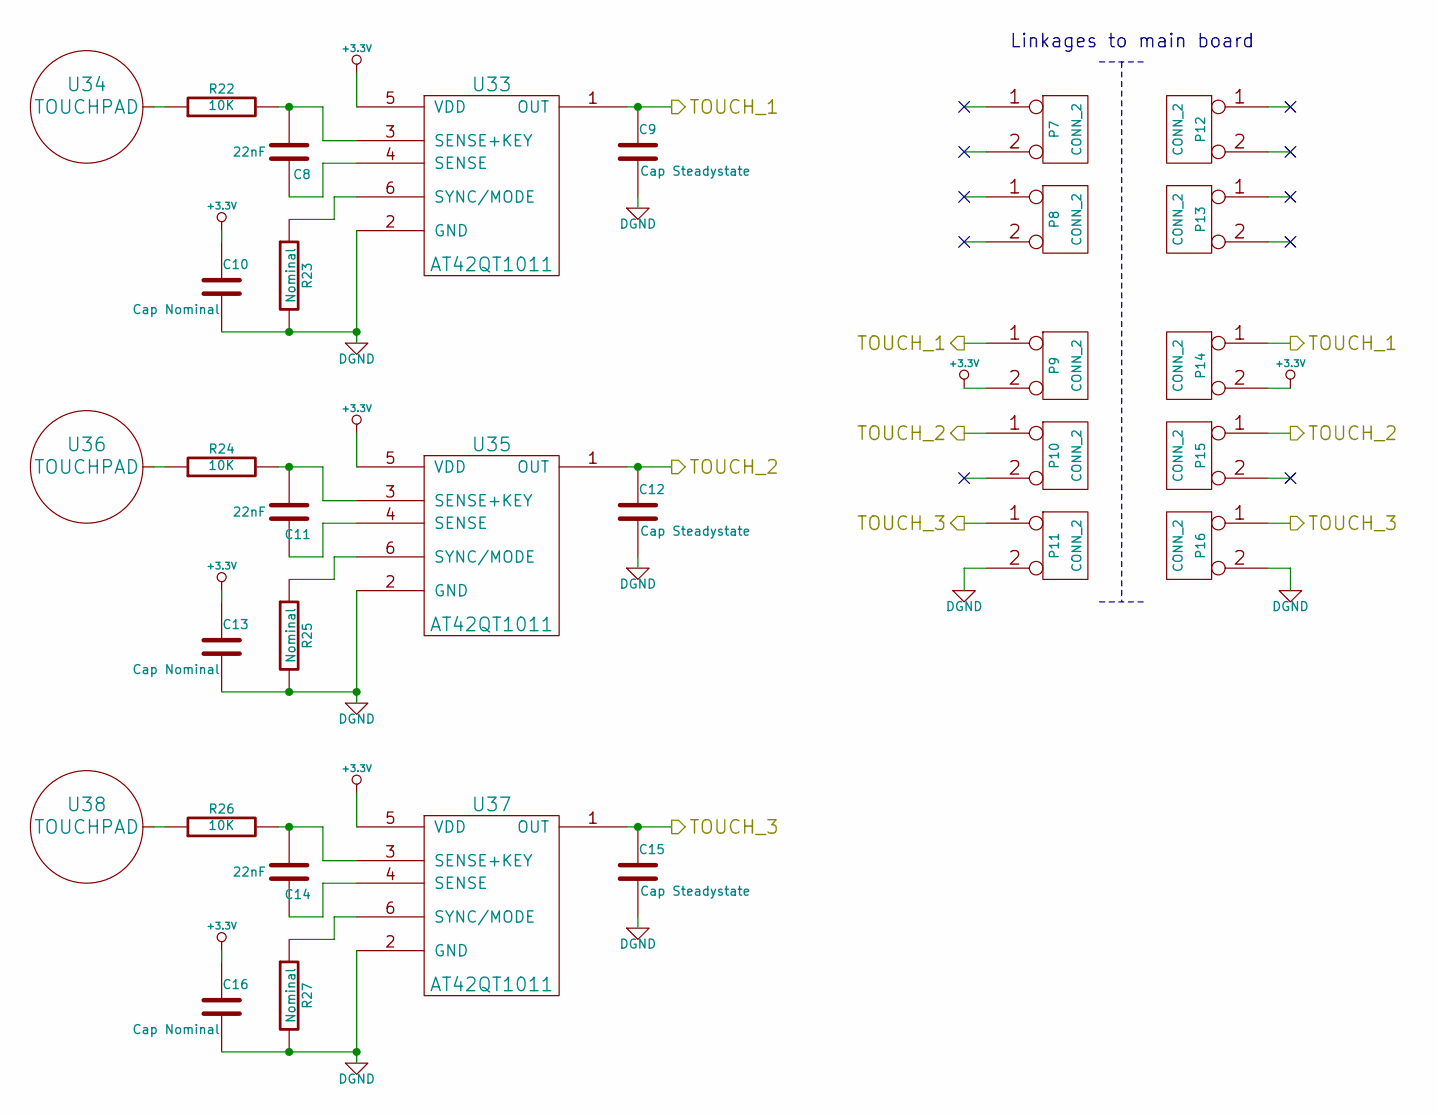
[picture p32: schematic sensors_touch.sch]

Parts:
C8, C11, C14: 22nF
C9, C12, C15: Cap Steadystate
C10, C13, C16: Cap Nominal
P7, P8, P9, P10, P11, P12, P13, P14, P15, P16: CONN_2
R22, R24, R26: 10K
R23, R25, R27: Nominal
U33, U35, U37: AT42QT1011
U34, U36, U38: TOUCHPAD

Connections:
+3.3V: C10.1, C13.1, C16.1, P9.2 (PM), P14.2 (PM), U33.5 (VDD), U35.5 (VDD), U37.5 (VDD); also elsewhere on the board
/micro_proc/TOUCH_1: C9.1, P9.1, P14.1, U33.1 (OUT); also elsewhere on the board
/micro_proc/TOUCH_2: C12.1, P10.1, P15.1, U35.1 (OUT); also elsewhere on the board
/micro_proc/TOUCH_3: C15.1, P11.1, P16.1, U37.1 (OUT); also elsewhere on the board
AGND: C9.2, C10.2, C12.2, C13.2, C15.2, C16.2, P11.2 (PM), P16.2 (PM), R23.2, R25.2, R27.2, U33.2 (GND), U35.2 (GND), U37.2 (GND); also elsewhere on the board
unnamed: R25.1, U35.6 (SYNC/MODE)
unnamed: C11.1, U35.4 (SENSE)
unnamed: R24.1, U36.1
unnamed: C11.2, R24.2, U35.3 (SENSE+KEY)
unnamed: R22.1, U34.1
unnamed: C8.2, R22.2, U33.3 (SENSE+KEY)
unnamed: C8.1, U33.4 (SENSE)
unnamed: R23.1, U33.6 (SYNC/MODE)
unnamed: C14.2, R26.2, U37.3 (SENSE+KEY)
unnamed: C14.1, U37.4 (SENSE)
unnamed: R27.1, U37.6 (SYNC/MODE)
unnamed: R26.1, U38.1

Notes on the sheet:
Linkages to main board

Schematic: output_signal_brake_2.sch

Parts:
C17, C18, C19, C20: Cap Nominal
C21, C22: 22uF
C23, C24: 10nF
D36: LED_GENERIC_SMD
L1: 1uH
P1: CONN_6_RA_MALE
P2, P3: CONN_2x2_MALE_RA
P4, P6: CONN_2x2_FEMALE_BACK
P5: CONN_6_FEMALE_FRONT
R37, R38, R39: 270
R40, R43: Nominal
R41: 160k
R42: 300
R44: 75k
U39, U40, U41: TLC59108IPWR
U42: TPS62090

Connections:
+2.5V: C22.1, L1.2, P1.1, P2.1, P2.4, P4.1, P4.4, P5.1, R41.1, R42.1, R43.1, U42.16 (VOS); also elsewhere on the board
+3.3V: C17.1, C18.1, C19.1, C20.1, P1.2, P2.2, P4.2, P5.2, R40.1, U39.2 (A0), U39.20 (VCC), U40.3 (A1), U40.20 (VCC), U41.2 (A0), U41.3 (A1), U41.20 (VCC); also elsewhere on the board
/battery_charger/SCL: P1.3, P3.2, P5.3, P6.2, U39.18 (SCL), U40.18 (SCL), U41.18 (SCL); also elsewhere on the board
/battery_charger/SDA: P1.4, P3.3, P5.4, P6.3, U39.19 (SDA), U40.19 (SDA), U41.19 (SDA); also elsewhere on the board
/output_signal_brake_2/BATT_IN: C21.1, U42.3 (FREQ), U42.10 (AVIN), U42.11 (PVIN), U42.12 (PVIN), U42.13 (EN); also elsewhere on the board
/output_signal_brake_2/PWR_GOOD: R43.2, U42.4 (PG); also elsewhere on the board
/output_signal_brake_2/brake_leds/CATHODE_1: U41.6 (~OUT0); also elsewhere on the board
/output_signal_brake_2/brake_leds/CATHODE_2: U41.7 (~OUT1); also elsewhere on the board
/output_signal_brake_2/brake_leds/CATHODE_3: U41.9 (~OUT2); also elsewhere on the board
/output_signal_brake_2/brake_leds/CATHODE_4: U41.10 (~OUT3); also elsewhere on the board
/output_signal_brake_2/brake_leds/CATHODE_5: U41.11 (~OUT4); also elsewhere on the board
/output_signal_brake_2/brake_leds/CATHODE_6: U41.12 (~OUT5); also elsewhere on the board
/output_signal_brake_2/brake_leds/CATHODE_7: U41.14 (~OUT6); also elsewhere on the board
/output_signal_brake_2/brake_leds/CATHODE_8: U41.15 (~OUT7); also elsewhere on the board
/output_signal_brake_2/signal_leds_back/CATHODE_1: U40.6 (~OUT0); also elsewhere on the board
/output_signal_brake_2/signal_leds_back/CATHODE_2: U40.7 (~OUT1); also elsewhere on the board
/output_signal_brake_2/signal_leds_back/CATHODE_3: U40.9 (~OUT2); also elsewhere on the board
/output_signal_brake_2/signal_leds_back/CATHODE_4: U40.10 (~OUT3); also elsewhere on the board
/output_signal_brake_2/signal_leds_back/CATHODE_5: U40.11 (~OUT4); also elsewhere on the board
/output_signal_brake_2/signal_leds_back/CATHODE_6: U40.12 (~OUT5); also elsewhere on the board
/output_signal_brake_2/signal_leds_back/CATHODE_7: U40.14 (~OUT6); also elsewhere on the board
/output_signal_brake_2/signal_leds_back/CATHODE_8: U40.15 (~OUT7); also elsewhere on the board
/output_signal_brake_2/signal_leds_front/CATHODE_1: U39.6 (~OUT0); also elsewhere on the board
/output_signal_brake_2/signal_leds_front/CATHODE_2: U39.7 (~OUT1); also elsewhere on the board
/output_signal_brake_2/signal_leds_front/CATHODE_3: U39.9 (~OUT2); also elsewhere on the board
/output_signal_brake_2/signal_leds_front/CATHODE_4: U39.10 (~OUT3); also elsewhere on the board
/output_signal_brake_2/signal_leds_front/CATHODE_5: U39.11 (~OUT4); also elsewhere on the board
/output_signal_brake_2/signal_leds_front/CATHODE_6: U39.12 (~OUT5); also elsewhere on the board
/output_signal_brake_2/signal_leds_front/CATHODE_7: U39.14 (~OUT6); also elsewhere on the board
/output_signal_brake_2/signal_leds_front/CATHODE_8: U39.15 (~OUT7); also elsewhere on the board
/output_signal_brake_2/~RESET: P1.5, P2.3, P4.3, P5.5, R40.2, U39.17 (~RESET), U40.17 (~RESET), U41.17 (~RESET); also elsewhere on the board
AGND: C17.2, C18.2, C19.2, C20.2, C21.2, C22.2, C24.2, D36.2 (Cathode), P1.6, P3.1, P3.4, P5.6, P6.1, P6.4, R37.2, R38.2, R39.2, R44.2, U39.3 (A1), U39.4 (A2), U39.5 (A3), U39.8 (GND), U39.13 (GND), U39.16 (GND), U40.2 (A0), U40.4 (A2), U40.5 (A3), U40.8 (GND), U40.13 (GND), U40.16 (GND), U41.4 (A2), U41.5 (A3), U41.8 (GND), U41.13 (GND), U41.16 (GND), U42.6 (AGND), U42.14 (PGND), U42.15 (PGND), U42.17 (Thermal_Pad); also elsewhere on the board
unnamed: D36.1 (Anode), R42.2
unnamed: R38.1, U40.1 (R_EXT)
unnamed: R37.1, U39.1 (R_EXT)
unnamed: R39.1, U41.1 (R_EXT)
unnamed: L1.1, U42.1 (SW), U42.2 (SW)
unnamed: C23.2, U42.8 (CN)
unnamed: C24.1, U42.9 (SS)
unnamed: C23.1, U42.7 (CP)
unnamed: R41.2, R44.1, U42.5 (FB)

Notes on the sheet:
Turn Signal
Brake Signal
70mA
Slave Address 1000-001x
Slave Address 1000-011x
L/R Handlebars
Helmet
Battery to 2.5V Buck Power Supply
Indicator LED
1.9V @ 2mA
Slave Address 1000-010x
1.4MHz operation
-30%< L <+20%
-50% < C < +20%

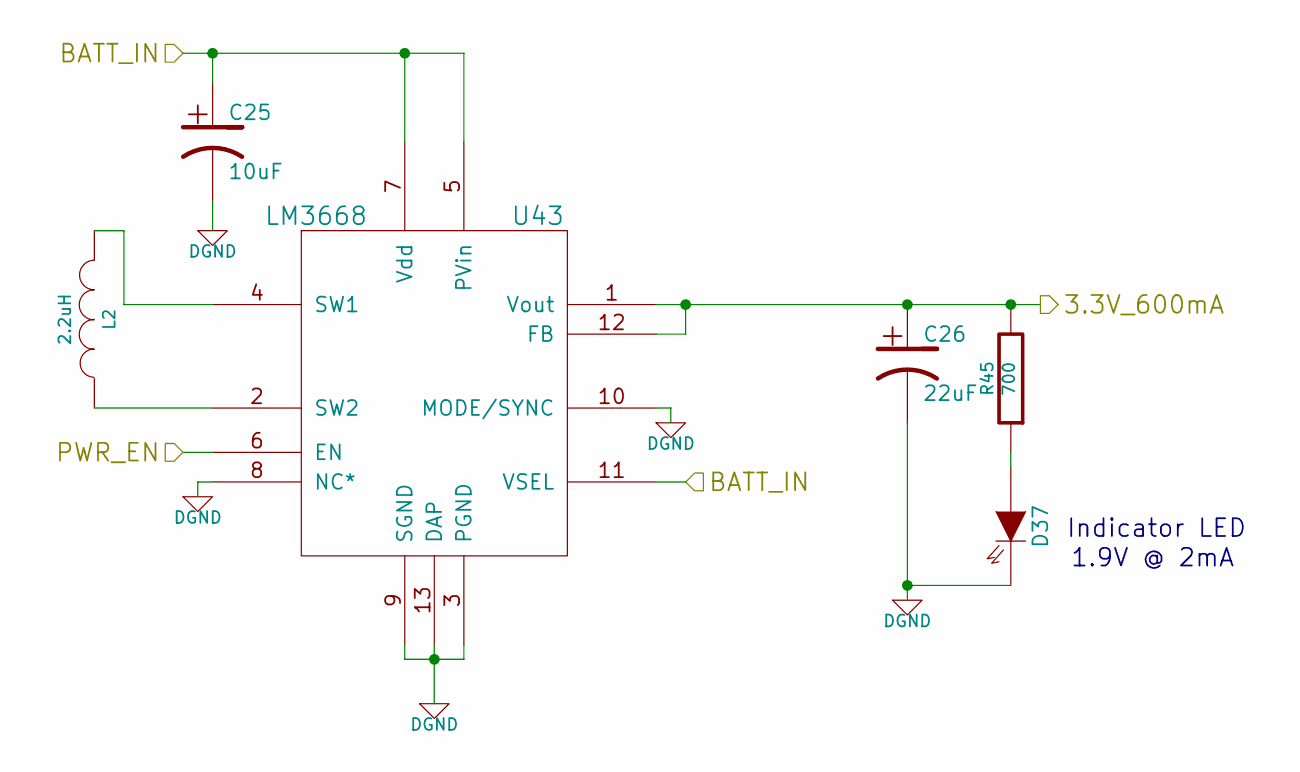
[picture p33: schematic power_regulation.sch]

Parts:
C25: 10uF
C26: 22uF
D37: LED_GENERIC_SMD
L2: 2.2uH
R45: 700
U43: LM3668

Connections:
+3.3V: C26.1, R45.2, U43.1 (Vout), U43.12 (FB); also elsewhere on the board
/output_signal_brake_2/BATT_IN: C25.1, U43.5 (PVin), U43.6 (EN), U43.7 (Vdd), U43.11 (VSEL); also elsewhere on the board
AGND: C25.2, C26.2, D37.2 (Cathode), U43.3 (PGND), U43.8 (NC*), U43.9 (SGND), U43.10 (MODE/SYNC), U43.13 (DAP); also elsewhere on the board
unnamed: D37.1 (Anode), R45.1
unnamed: L2.2, U43.4 (SW1)
unnamed: L2.1, U43.2 (SW2)

Notes on the sheet:
Indicator LED
1.9V @ 2mA

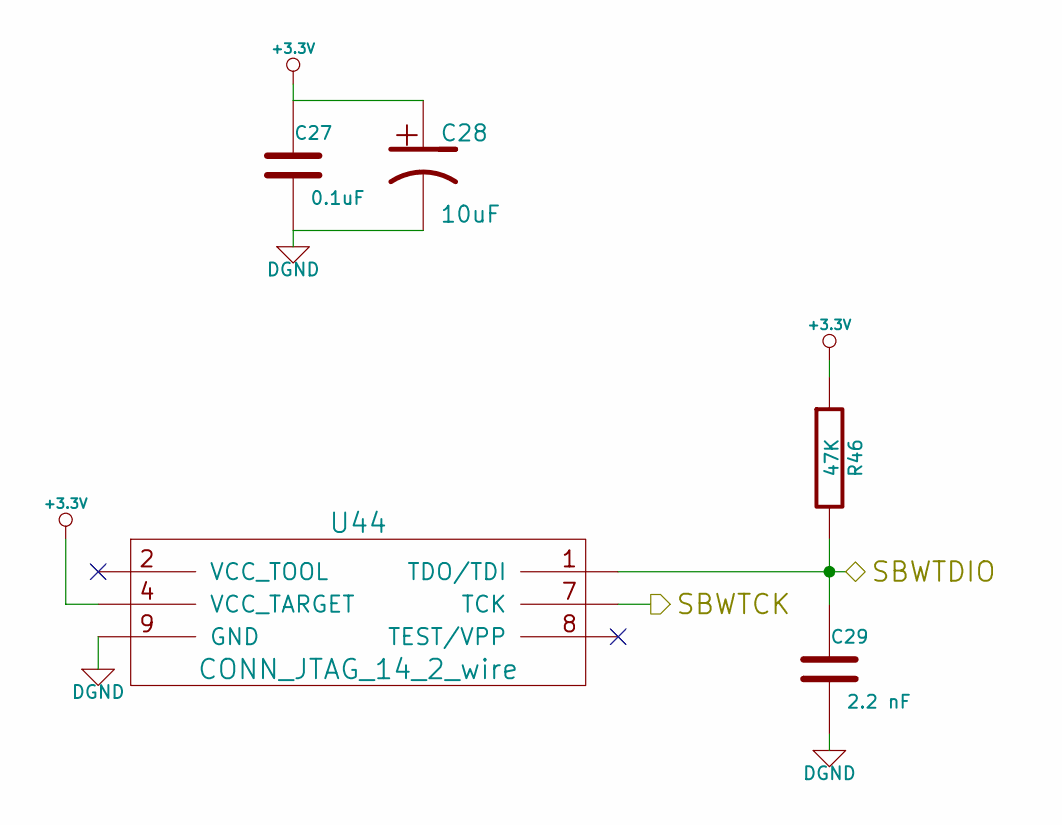
[picture p34: schematic interface_JTAG_2_wire.sch]

Parts:
C27: 0.1uF
C28: 10uF
C29: 2.2 nF
R46: 47K
U44: CONN_JTAG_14_2_wire

Connections:
+3.3V: C27.1, C28.1, R46.1, U44.4 (VCC_TARGET); also elsewhere on the board
/interface_JTAG_2_wire/SBWTCK: U44.7 (TCK); also elsewhere on the board
/interface_JTAG_2_wire/SBWTDIO: C29.1, R46.2, U44.1 (TDO/TDI); also elsewhere on the board
AGND: C27.2, C28.2, C29.2, U44.9 (GND); also elsewhere on the board

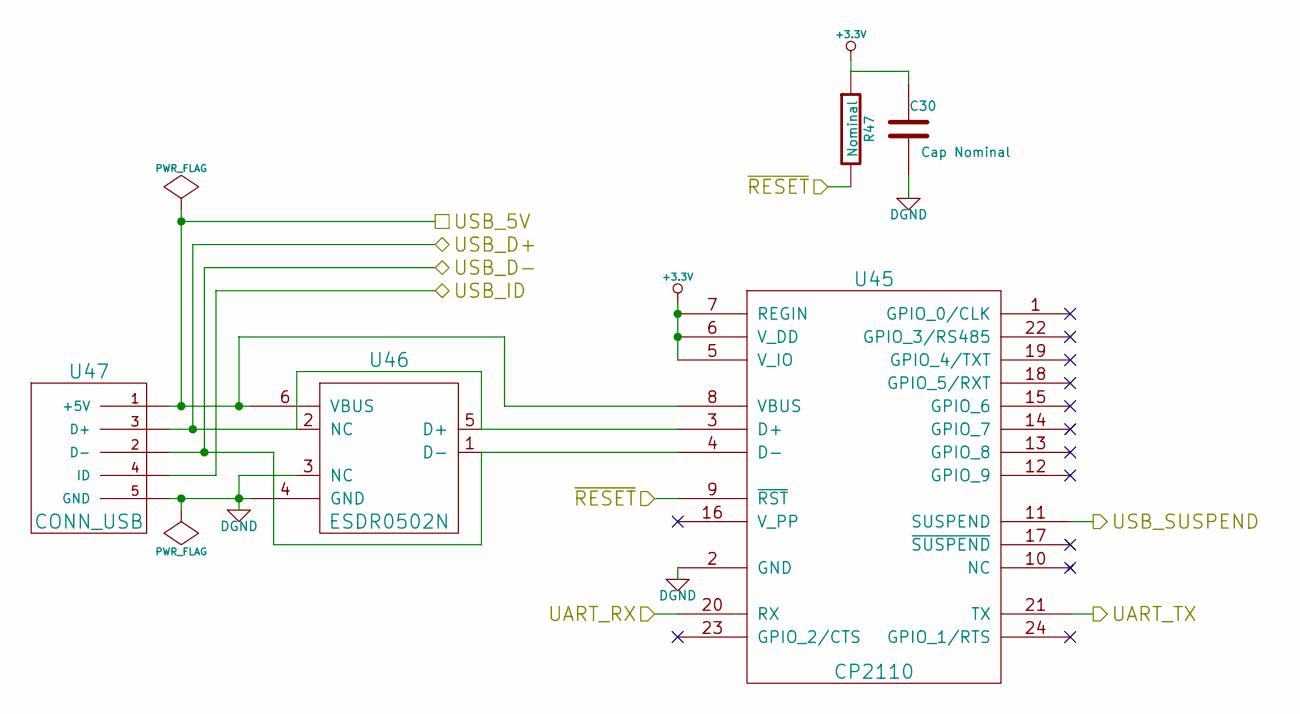
[picture p35: schematic interface_usb.sch]

Parts:
C30: Cap Nominal
R47: Nominal
U45: CP2110
U46: ESDR0502N
U47: CONN_USB

Connections:
+3.3V: C30.1, R47.1, U45.5 (V_IO), U45.6 (V_DD), U45.7 (REGIN); also elsewhere on the board
/battery_charger/USB_5V: U45.8 (VBUS), U46.6 (VBUS), U47.1 (+5V); also elsewhere on the board
/battery_charger/USB_D+: U45.3 (D+), U46.2 (NC), U46.5 (D+), U47.3 (D+); also elsewhere on the board
/battery_charger/USB_D-: U45.4 (D-), U46.1 (D-), U47.2 (D-); also elsewhere on the board
/interface_usb/UART_RX: U45.20 (RX); also elsewhere on the board
/interface_usb/USB_ID: U47.4 (ID); also elsewhere on the board
/interface_usb/USB_SUSPEND: U45.11 (SUSPEND); also elsewhere on the board
/interface_usb/~RESET: R47.2, U45.9 (~RST); also elsewhere on the board
/micro_proc/UART_RX: U45.21 (TX); also elsewhere on the board
AGND: C30.2, U45.2 (GND), U46.3 (NC), U46.4 (GND), U47.5 (GND); also elsewhere on the board

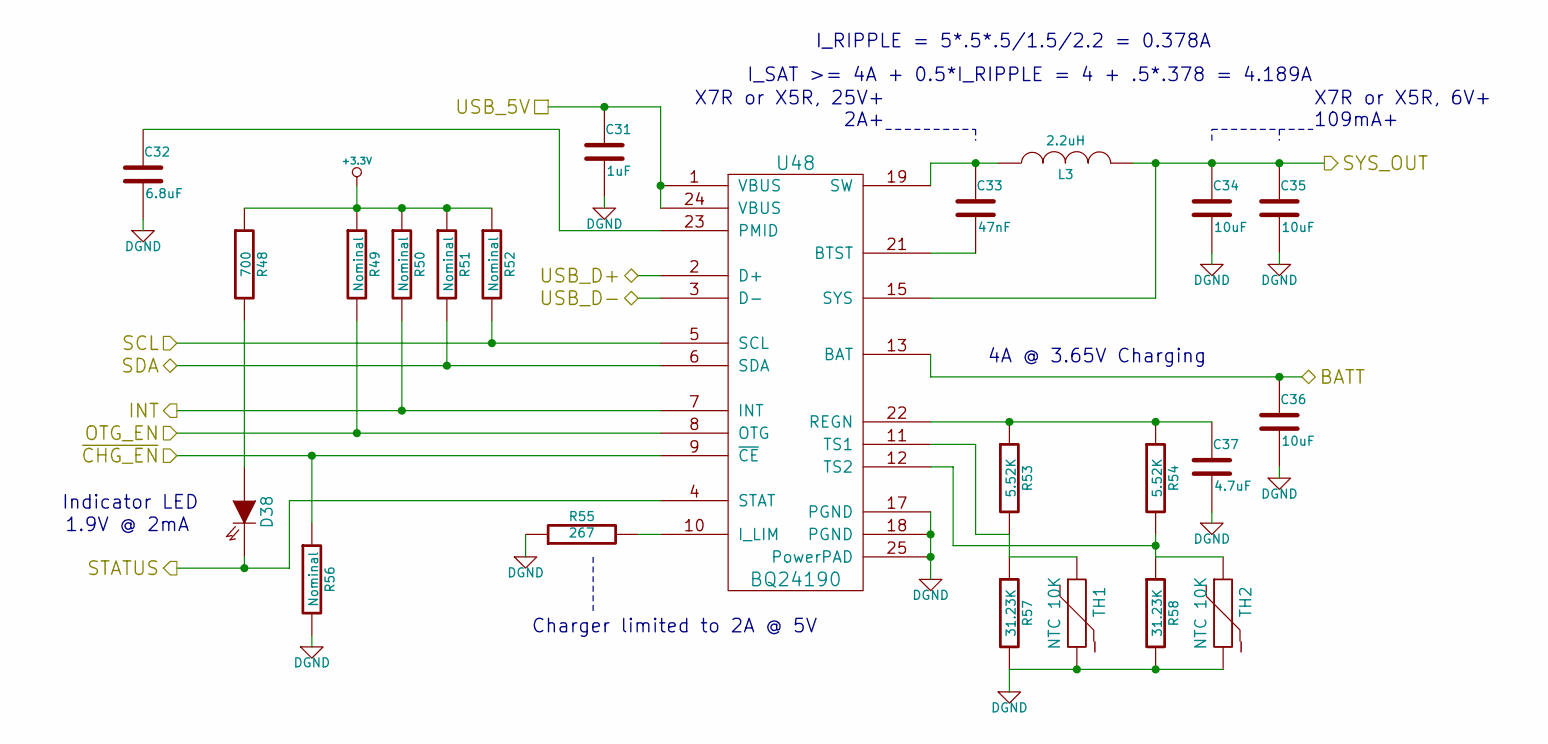
[picture p36: schematic battery_charger.sch]

Parts:
C31: 1uF
C32: 6.8uF
C33: 47nF
C34, C35, C36: 10uF
C37: 4.7uF
D38: LED_GENERIC_SMD
L3: 2.2uH
R48: 700
R49, R50, R51, R52, R56: Nominal
R53, R54: 5.52K
R55: 267
R57, R58: 31.23K
TH1, TH2: NTC 10K
U48: BQ24190

Connections:
+3.3V: R48.1, R49.1, R50.1, R51.1, R52.1; also elsewhere on the board
/battery_charger/BATT: C36.1, U48.13 (BAT), U48.14 (BAT); also elsewhere on the board
/battery_charger/INT: R50.2, U48.7 (INT); also elsewhere on the board
/battery_charger/OTG_EN: R49.2, U48.8 (OTG); also elsewhere on the board
/battery_charger/SCL: R52.2, U48.5 (SCL); also elsewhere on the board
/battery_charger/SDA: R51.2, U48.6 (SDA); also elsewhere on the board
/battery_charger/STATUS: D38.2 (Cathode), U48.4 (STAT); also elsewhere on the board
/battery_charger/USB_5V: C31.1, U48.1 (VBUS), U48.24 (VBUS); also elsewhere on the board
/battery_charger/USB_D+: U48.2 (D+); also elsewhere on the board
/battery_charger/USB_D-: U48.3 (D-); also elsewhere on the board
/battery_charger/~CHG_EN: R56.1, U48.9 (~CE); also elsewhere on the board
/output_signal_brake_2/BATT_IN: C34.1, C35.1, L3.2, U48.15 (SYS), U48.16 (SYS); also elsewhere on the board
AGND: C31.2, C32.2, C34.2, C35.2, C36.2, C37.2, R55.1, R56.2, R57.2, R58.2, TH1.2, TH2.2, U48.17 (PGND), U48.18 (PGND), U48.25 (PowerPAD); also elsewhere on the board
unnamed: C33.1, L3.1, U48.19 (SW), U48.20 (SW)
unnamed: C33.2, U48.21 (BTST)
unnamed: C32.1, U48.23 (PMID)
unnamed: D38.1 (Anode), R48.2
unnamed: R53.2, R57.1, TH1.1, U48.11 (TS1)
unnamed: R54.2, R58.1, TH2.1, U48.12 (TS2)
unnamed: C37.1, R53.1, R54.1, U48.22 (REGN)
unnamed: R55.2, U48.10 (I_LIM)

Notes on the sheet:
X7R or X5R, 25V+ 2A+
X7R or X5R, 6V+ 109mA+
4A @ 3.65V Charging
Charger limited to 2A @ 5V
I_SAT >= 4A + 0.5*I_RIPPLE = 4 + .5*.378 = 4.189A
I_RIPPLE = 5*.5*.5/1.5/2.2 = 0.378A
Indicator LED
1.9V @ 2mA

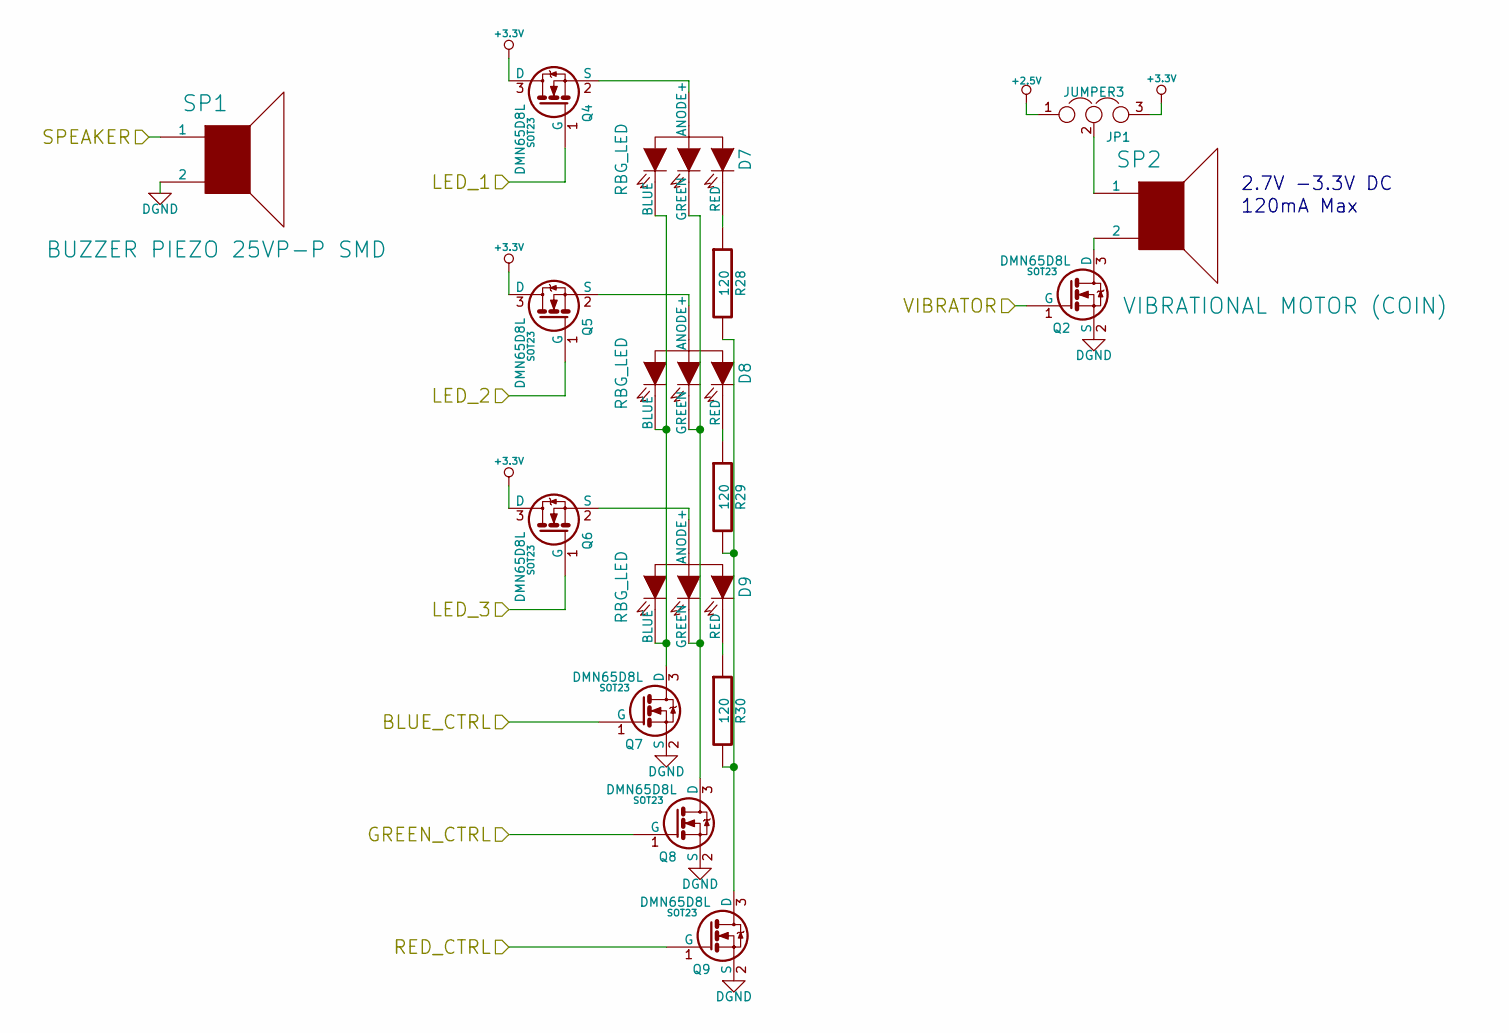
[picture p37: schematic output_general.sch]

Parts:
D7, D8, D9: RBG_LED
JP1: JUMPER3
Q2, Q4, Q5, Q6, Q7, Q8, Q9: DMN65D8L; SOT23
R28, R29, R30: 120
SP1: BUZZER PIEZO 25VP-P SMD
SP2: VIBRATIONAL MOTOR (COIN)

Connections:
+2.5V: JP1.1; also elsewhere on the board
+3.3V: JP1.3, Q4.3 (D), Q5.3 (D), Q6.3 (D); also elsewhere on the board
/micro_proc/LED_1: Q4.1 (G); also elsewhere on the board
/micro_proc/LED_2: Q5.1 (G); also elsewhere on the board
/micro_proc/LED_3: Q6.1 (G); also elsewhere on the board
/micro_proc/SPEAKER: SP1.1; also elsewhere on the board
/micro_proc/VIBRATOR: Q2.1 (G); also elsewhere on the board
/output_general/BLUE_CTRL: Q7.1 (G); also elsewhere on the board
/output_general/GREEN_CTRL: Q8.1 (G); also elsewhere on the board
/output_general/RED_CTRL: Q9.1 (G); also elsewhere on the board
AGND: Q2.2 (S), Q7.2 (S), Q8.2 (S), Q9.2 (S), SP1.2; also elsewhere on the board
unnamed: D9.4 (ANODE+), Q6.2 (S)
unnamed: D8.4 (ANODE+), Q5.2 (S)
unnamed: D7.4 (ANODE+), Q4.2 (S)
unnamed: D7.1 (BLUE), D8.1 (BLUE), D9.1 (BLUE), Q7.3 (D)
unnamed: JP1.2, SP2.1
unnamed: Q2.3 (D), SP2.2
unnamed: D7.3 (GREEN), D8.3 (GREEN), D9.3 (GREEN), Q8.3 (D)
unnamed: D8.2 (RED), R29.1
unnamed: D7.2 (RED), R28.1
unnamed: Q9.3 (D), R28.2, R29.2, R30.2
unnamed: D9.2 (RED), R30.1

Notes on the sheet:
120mA Max
2.7V -3.3V DC

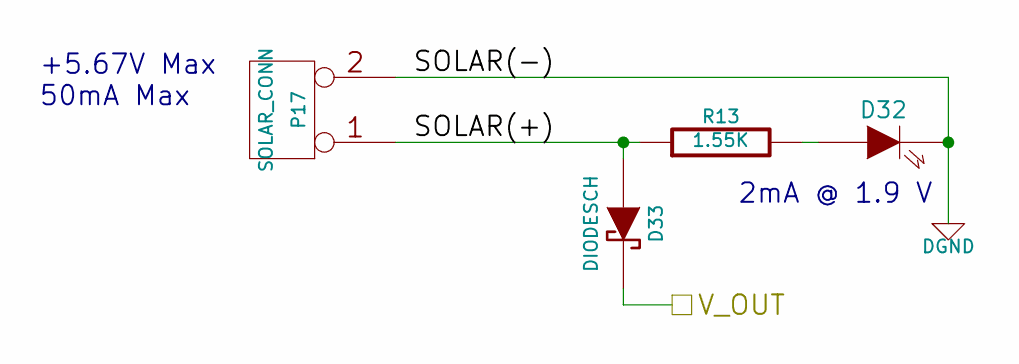
[picture p38: schematic interface_solar.sch]

Parts:
D32: LED_GENERIC_SMD
D33: DIODESCH
P17: SOLAR_CONN
R13: 1.55K

Connections:
/battery_charger/USB_5V: D33.2 (K); also elsewhere on the board
/interface_solar/SOLAR(+): D33.1 (A), P17.1, R13.1
AGND: D32.2 (Cathode), P17.2 (PM); also elsewhere on the board
unnamed: D32.1 (Anode), R13.2

Notes on the sheet:
2mA @ 1.9 V
+5.67V Max 50mA Max
