steamroller16/lightpipe/bike_light.kicad_pcb

## KiCad design bike_light.kicad_pcb (continued)

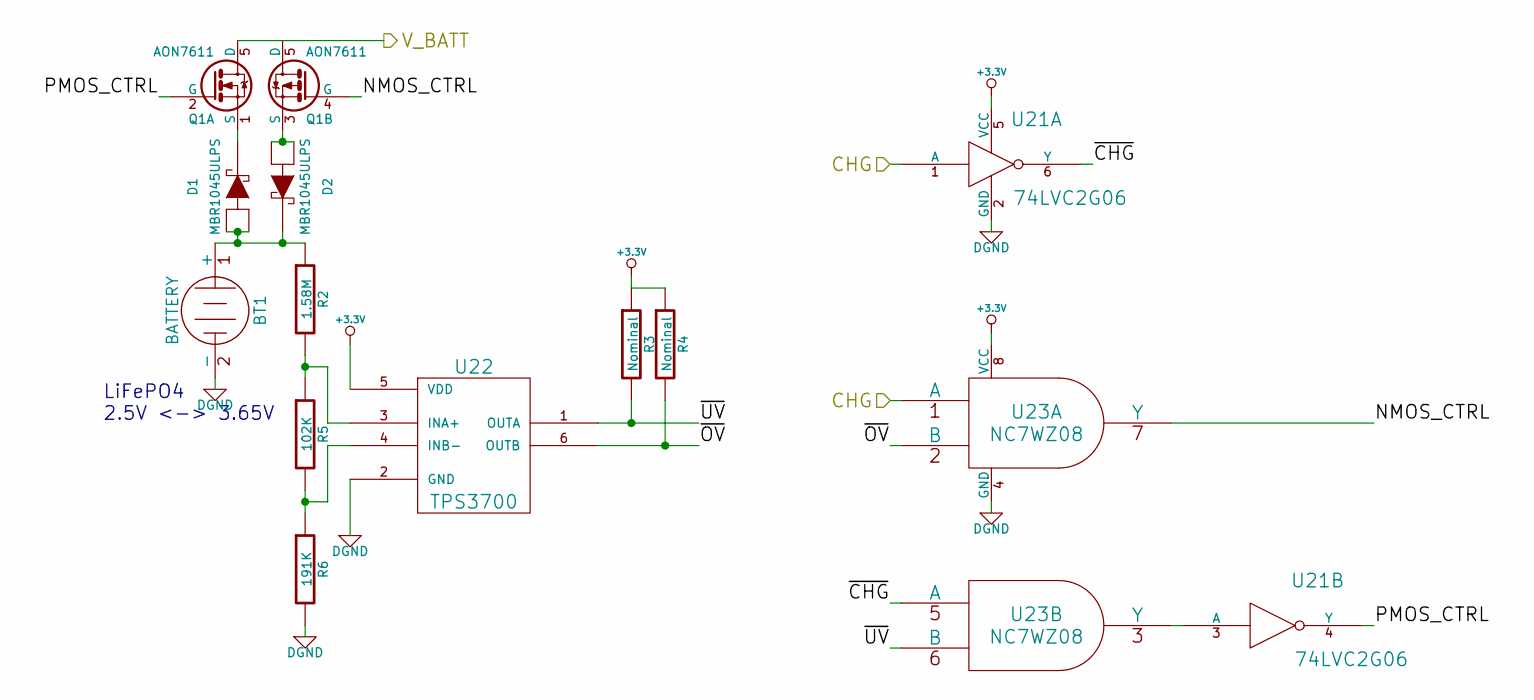
[picture p39: schematic battery_module.sch]

Parts:
BT1: BATTERY
D1, D2: MBR1045ULPS
Q1: AON7611
R2: 1.58M
R3, R4: Nominal
R5: 102K
R6: 191K
U21: 74LVC2G06
U22: TPS3700
U23: NC7WZ08

Connections:
+3.3V: R3.1, R4.1, U21.5 (VCC), U22.5 (VDD), U23.8 (VCC); also elsewhere on the board
/battery_pack/battery_module_1/CHG: U21.1 (A), U23.1 (A); also elsewhere on the board
/battery_pack/battery_module_1/NMOS_CTRL: Q1.4 (G), U23.7 (Y)
/battery_pack/battery_module_1/PMOS_CTRL: Q1.2 (G), U21.4 (Y)
/battery_pack/battery_module_1/V_BATT: Q1.5 (D); also elsewhere on the board
/battery_pack/battery_module_1/~CHG: U21.6 (Y), U23.5 (A)
/battery_pack/battery_module_1/~OV: R4.2, U22.6 (OUTB), U23.2 (B)
/battery_pack/battery_module_1/~UV: R3.2, U22.1 (OUTA), U23.6 (B)
AGND: BT1.2 (-), R6.2, U21.2 (GND), U22.2 (GND), U23.4 (GND); also elsewhere on the board
unnamed: U21.3 (A), U23.3 (Y)
unnamed: D1.3 (Cathode), Q1.1 (S)
unnamed: BT1.1 (+), D1.1 (Anode), D1.2 (Anode), D2.3 (Cathode), R2.1
unnamed: D2.1 (Anode), D2.2 (Anode), Q1.3 (S)
unnamed: R5.2, R6.1, U22.4 (INB-)
unnamed: R2.2, R5.1, U22.3 (INA+)

Parts of its further copies:
BT2, BT3: BATTERY
Q3: AON7611
R14: Nominal
R15: 102K
R16: 191K
U24, U27: 74LVC2G06
U25, U28: TPS3700
U26, U29: NC7WZ08

Notes on the sheet:
LiFePO4 2.5V <-> 3.65V

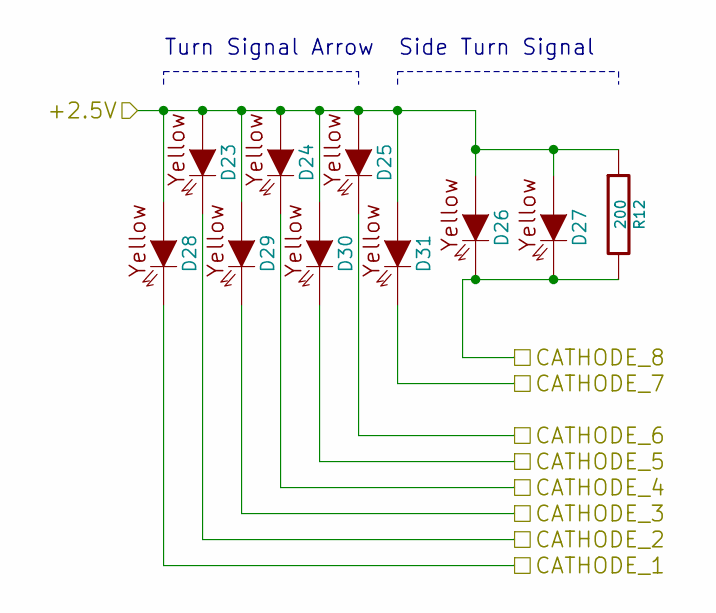
[picture p40: schematic signal_leds.sch]

Parts:
D3, D4, D5, D11, D12, D13, D14: LY-E63F
D6, D10: LY-A67F
R7: 200

Connections:
+2.5V: D3.1 (Anode), D3.2 (Anode), D3.3 (Anode), D4.1 (Anode), D4.2 (Anode), D4.3 (Anode), D5.1 (Anode), D5.2 (Anode), D5.3 (Anode), D6.1 (Anode), D10.1 (Anode), D11.1 (Anode), D11.2 (Anode), D11.3 (Anode), D12.1 (Anode), D12.2 (Anode), D12.3 (Anode), D13.1 (Anode), D13.2 (Anode), D13.3 (Anode), D14.1 (Anode), D14.2 (Anode), D14.3 (Anode), R7.1; also elsewhere on the board
/output_signal_brake_2/signal_leds_front/CATHODE_1: D11.4 (Cathode); also elsewhere on the board
/output_signal_brake_2/signal_leds_front/CATHODE_2: D3.4 (Cathode); also elsewhere on the board
/output_signal_brake_2/signal_leds_front/CATHODE_3: D12.4 (Cathode); also elsewhere on the board
/output_signal_brake_2/signal_leds_front/CATHODE_4: D4.4 (Cathode); also elsewhere on the board
/output_signal_brake_2/signal_leds_front/CATHODE_5: D13.4 (Cathode); also elsewhere on the board
/output_signal_brake_2/signal_leds_front/CATHODE_6: D5.4 (Cathode); also elsewhere on the board
/output_signal_brake_2/signal_leds_front/CATHODE_7: D14.4 (Cathode); also elsewhere on the board
/output_signal_brake_2/signal_leds_front/CATHODE_8: D6.2 (Cathode), D10.2 (Cathode), R7.2; also elsewhere on the board

Parts of its further copies:
D23, D24, D25, D28, D29, D30, D31: LY-E63F
D26, D27: LY-A67F
R12: 200

Connections of its further copies:
+2.5V: D23.1 (Anode), D23.2 (Anode), D23.3 (Anode), D24.1 (Anode), D24.2 (Anode), D24.3 (Anode), D25.1 (Anode), D25.2 (Anode), D25.3 (Anode), D26.1 (Anode), D27.1 (Anode), D28.1 (Anode), D28.2 (Anode), D28.3 (Anode), D29.1 (Anode), D29.2 (Anode), D29.3 (Anode), D30.1 (Anode), D30.2 (Anode), D30.3 (Anode), D31.1 (Anode), D31.2 (Anode), D31.3 (Anode), R12.1; also elsewhere on the board
/output_signal_brake_2/signal_leds_back/CATHODE_1: D28.4 (Cathode); also elsewhere on the board
/output_signal_brake_2/signal_leds_back/CATHODE_2: D23.4 (Cathode); also elsewhere on the board
/output_signal_brake_2/signal_leds_back/CATHODE_3: D29.4 (Cathode); also elsewhere on the board
/output_signal_brake_2/signal_leds_back/CATHODE_4: D24.4 (Cathode); also elsewhere on the board
/output_signal_brake_2/signal_leds_back/CATHODE_5: D30.4 (Cathode); also elsewhere on the board
/output_signal_brake_2/signal_leds_back/CATHODE_6: D25.4 (Cathode); also elsewhere on the board
/output_signal_brake_2/signal_leds_back/CATHODE_7: D31.4 (Cathode); also elsewhere on the board
/output_signal_brake_2/signal_leds_back/CATHODE_8: D26.2 (Cathode), D27.2 (Cathode), R12.2; also elsewhere on the board

Notes on the sheet:
Turn Signal Arrow
Side Turn Signal

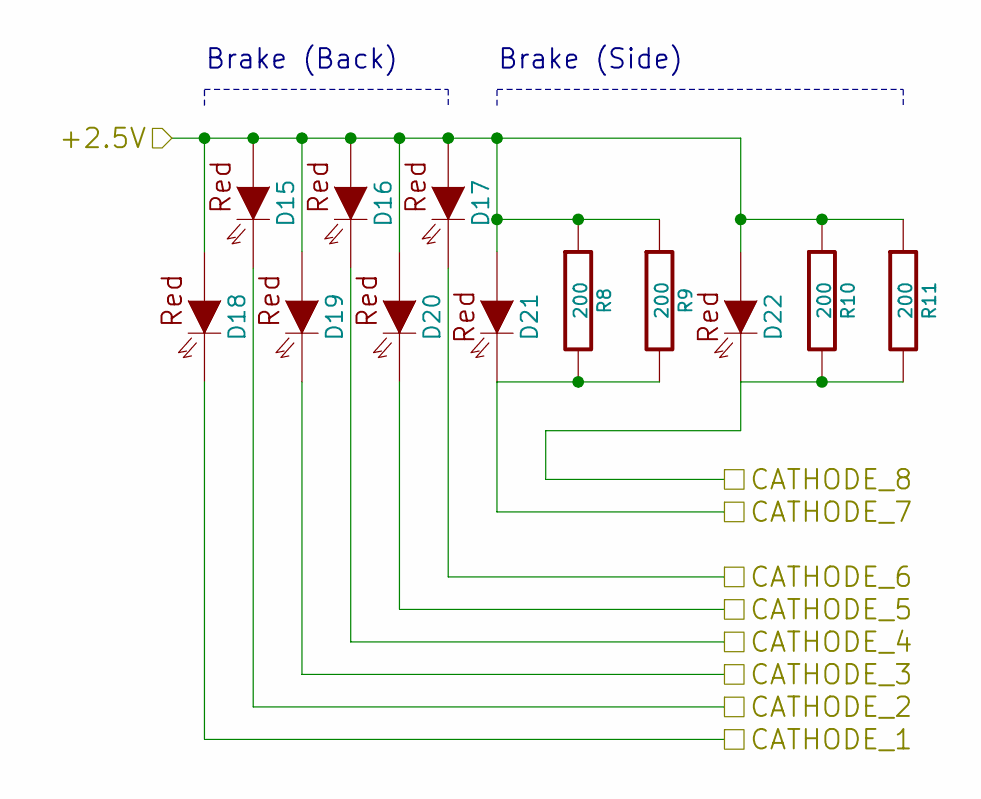
[picture p41: schematic brake_leds.sch]

Parts:
D15, D16, D17, D18, D19, D20: LS-E63F
D21, D22: LR-A67F
R8, R9, R10, R11: 200

Connections:
+2.5V: D15.1 (Anode), D15.2 (Anode), D15.3 (Anode), D16.1 (Anode), D16.2 (Anode), D16.3 (Anode), D17.1 (Anode), D17.2 (Anode), D17.3 (Anode), D18.1 (Anode), D18.2 (Anode), D18.3 (Anode), D19.1 (Anode), D19.2 (Anode), D19.3 (Anode), D20.1 (Anode), D20.2 (Anode), D20.3 (Anode), D21.1 (Anode), D22.1 (Anode), R8.1, R9.1, R10.1, R11.1; also elsewhere on the board
/output_signal_brake_2/brake_leds/CATHODE_1: D18.4 (Cathode); also elsewhere on the board
/output_signal_brake_2/brake_leds/CATHODE_2: D15.4 (Cathode); also elsewhere on the board
/output_signal_brake_2/brake_leds/CATHODE_3: D19.4 (Cathode); also elsewhere on the board
/output_signal_brake_2/brake_leds/CATHODE_4: D16.4 (Cathode); also elsewhere on the board
/output_signal_brake_2/brake_leds/CATHODE_5: D20.4 (Cathode); also elsewhere on the board
/output_signal_brake_2/brake_leds/CATHODE_6: D17.4 (Cathode); also elsewhere on the board
/output_signal_brake_2/brake_leds/CATHODE_7: D21.2 (Cathode), R8.2, R9.2; also elsewhere on the board
/output_signal_brake_2/brake_leds/CATHODE_8: D22.2 (Cathode), R10.2, R11.2; also elsewhere on the board

Notes on the sheet:
Brake (Back)
Brake (Side)

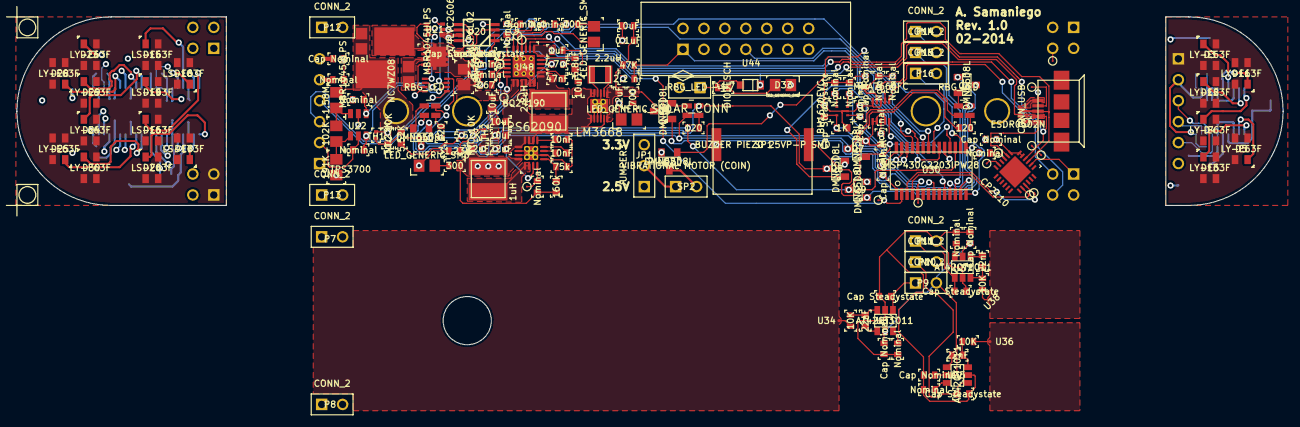
[picture p42: board bike_light.kicad_pcb from above]

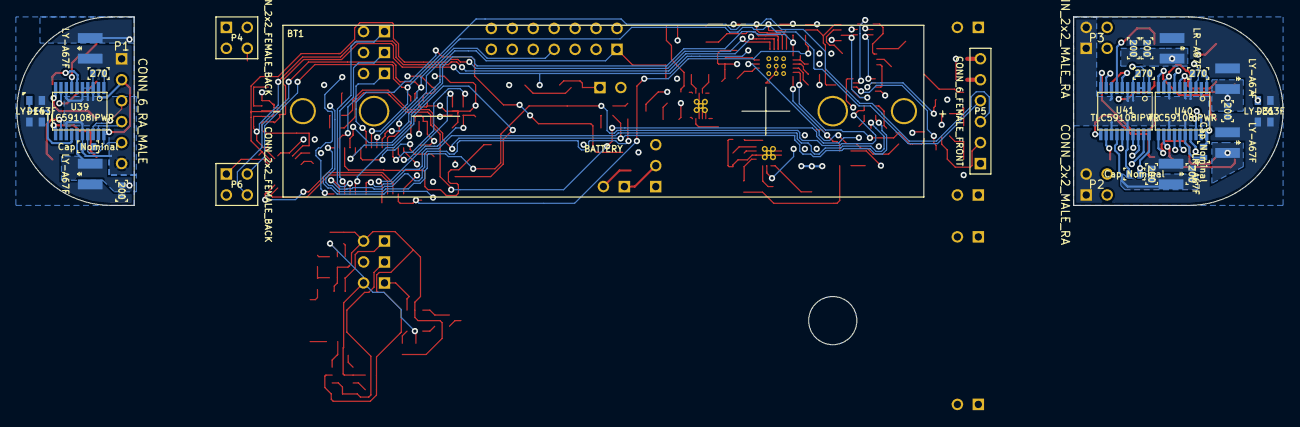
[picture p43: board bike_light.kicad_pcb from below]

Board: 4 copper layers, 153.5 x 39.8 mm, 198 parts (30 on the bottom side), 121 nets.
