steamroller16/lightpipe/code/src/sensor_accelerometer.c

//-----------------------------------------------------------
//-----------------------------------------------------------
// sensor_accelerometer.c
//-----------------------------------------------------------
// accelerometer: each reading, check to see what the acceleration is [-x dir for this geometry]. if the forward acceleration is greater than a preset threshold, then the bike is starting from a stop. When a person stops, the acceleration goes negative, goes to zero, goes positive, then back to zero (assuming no further oscillations). Therefore, the setting of that threshold prevents spurious brake light flickering at a stop.
sensor_accelerometer_init

sensor_accelerometer_read_x(void)
{
	// Read from the accelerometer x dir
}

sensor_accelerometer_isr
{
	current_accel_x = sensor_accelerometer_read_x(void);
	
	if(sensor_accelerometer_is_braking)
	{
		output_brake_lights_turn_on(void);
	}
	else if(sensor_accelerometer_is_pedaling)
	{
		output_brake_lights_turn_off(void);
	}
}



int sensor_accelerometer_is_pedaling(void)
{
	// Check to see if reading is greater than accel threshold
}

int sensor_accelerometer_is_braking(void)
{
	// Check to see if reading is lower than 
}
//-----------------------------------------------------------
//-----------------------------------------------------------
