steamroller16/lightpipe/code/src/output_speaker.c

//-----------------------------------------------------------
//-----------------------------------------------------------
// output_speaker.c
#include "output_speaker.h"
//-----------------------------------------------------------
void output_speaker_init(void)
{
//P2.4/TA1.2
	///SPEAKER
	P2DIR |= BIT4;
}

void output_speaker_flick(void)
{
	P2OUT ^= ( BIT4 );
}
//-----------------------------------------------------------
//-----------------------------------------------------------
