steamroller16/lightpipe/code/src/output_speaker.h

//-----------------------------------------------------------
// output_speaker.h
//-----------------------------------------------------------
#ifndef OUTPUT_SPEAKER_H
#define OUTPUT_SPEAKER_H
//-----------------------------------------------------------
// Dependencies
//-----------------------------------------------------------
#include <msp430.h>
//-----------------------------------------------------------
// # Defines
//-----------------------------------------------------------
// None.
//-----------------------------------------------------------
// Function prototypes
//-----------------------------------------------------------
void output_speaker_init(void);
void output_speaker_flick(void);
//-----------------------------------------------------------
//-----------------------------------------------------------
#endif
