steamroller16/lightpipe/code/src/output_brake_lights.c

//-----------------------------------------------------------
//-----------------------------------------------------------
// output_brake_lights.c
//-----------------------------------------------------------
output_brake_lights_adj_brightness(adjustment_val)
{

}
output_brake_lights_turn_on(void)
{

}
output_brake_lights_turn_off(void)
{

}


//-----------------------------------------------------------
//-----------------------------------------------------------
