steamroller16/lightpipe/code/src/output_signal_lights.c

//-----------------------------------------------------------
//-----------------------------------------------------------
// output_signal_lights.c
//-----------------------------------------------------------
output_signal_lights_adj_brightness(adjustment_val);
//-----------------------------------------------------------
//-----------------------------------------------------------
