steamroller16/lightpipe/code/src/pins.h

//-----------------------------------------------------------
// pins.h
//-----------------------------------------------------------
#ifndef PINS_H
#define PINS_H
//-----------------------------------------------------------
// Dependencies
//-----------------------------------------------------------
#include <msp430.h>
//-----------------------------------------------------------
// Function prototypes
//-----------------------------------------------------------
void setup_pins (void);
//-----------------------------------------------------------
//-----------------------------------------------------------
#endif
