steamroller16/lightpipe/code/src/util_wdt.h

//-----------------------------------------------------------
// util_wdt.h
//-----------------------------------------------------------
#ifndef UTIL_WDT_H
#define UTIL_WDT_H
//-----------------------------------------------------------
// Dependencies
//-----------------------------------------------------------
#include <msp430.h>
//-----------------------------------------------------------
// # Defines
//-----------------------------------------------------------
// None.
//-----------------------------------------------------------
// Function prototypes
//-----------------------------------------------------------
void util_wdt_init(void);
void util_wdt_pause(void);
void util_wdt_resume(void);
//-----------------------------------------------------------
//-----------------------------------------------------------
#endif
