steamroller16/lightpipe/code/src/util_uart.h

//-----------------------------------------------------------
// util_uart.h
//-----------------------------------------------------------
#ifndef UTIL_UART_H
#define UTIL_UART_H
//-----------------------------------------------------------
// Dependencies
//-----------------------------------------------------------
#include <msp430.h>
//-----------------------------------------------------------
// # Defines
//-----------------------------------------------------------

//-----------------------------------------------------------
// Function prototypes
//-----------------------------------------------------------
void util_uart_init(void);
void util_uart_write(char *msg, int length);
void util_uart_read(char *msg, int length);
//-----------------------------------------------------------
//-----------------------------------------------------------
#endif
