steamroller16/lightpipe/code/src/util_adc.h

//------------------------------------------------------------------------------
// util_adc.h
//------------------------------------------------------------------------------
// Utility: Functions to use ADC
//------------------------------------------------------------------------------
#ifndef UTIL_ADC_H
#define UTIL_ADC_H

//------------------------------------------------------------------------------
// Includes
//------------------------------------------------------------------------------


//------------------------------------------------------------------------------
// Defines and typedefs
//------------------------------------------------------------------------------


//------------------------------------------------------------------------------
// Public global variables
//------------------------------------------------------------------------------


//------------------------------------------------------------------------------
// Public function prototypes
//------------------------------------------------------------------------------
void util_adc_init(void);
void util_adc_start(int channel);
int util_adc_read(int channel);


//------------------------------------------------------------------------------
// End of file
//------------------------------------------------------------------------------
#endif
