steamroller16/lightpipe/(commit log)

2013-10-23 Kicad files
    [battery_pack.sch, bike_light.sch, external_conn.sch, front_headlight.sch, front_signal.sch, micro_proc.sch, power_regulation.sch, rear_brake.sch]
2013-11-07 Started working through components
    Going through the parts list from top to bottom. Got to the light
    sensor. Not done yet.
    [battery_pack.sch, bike_light.sch, external_conn.sch, front_headlight.sch, front_signal.sch, micro_proc.sch, power_regulation.sch, rear_brake.sch]
2013-11-08 Accelerometer done!
    progressin' like a beast
    [battery_pack.sch, bike_light.sch, external_conn.sch, front_headlight.sch, front_signal.sch, micro_proc.sch, power_regulation.sch, rear_brake.sch]
2013-11-10 Safety Lighting done!
    mmm getcha some of dis lighting... for safety...
    [battery_pack.sch, bike_light.sch, external_conn.sch, front_headlight.sch, front_signal.sch, lights_signal_brake.sch, micro_proc.sch, power_regulation.sch]
2013-11-11 Various components added
    USB conn, general outputs, brake signal, touch sensor
    [battery_pack.sch, bike_light.sch, external_conn.sch, front_headlight.sch, front_signal.sch, interface_usb.sch, lights_signal_brake.sch, micro_proc.sch]
2013-11-12 Battery management stuff
    :D
    [battery_module.sch, battery_pack.sch, bike_light.sch, interface_usb.sch, micro_proc.sch, output_general.sch, output_signal_brake.sch, power_regulation.sch]
2013-11-15 random minor thing
    [battery_module.sch, battery_pack.sch, bike_light.sch, interface_usb.sch, micro_proc.sch, output_general.sch, output_signal_brake.sch, power_regulation.sch]
2013-11-17 Added comments to schematic
    shows what needs to be done
    [battery_module.sch, battery_pack.sch, bike_light.sch, interface_usb.sch, micro_proc.sch, output_general.sch, output_signal_brake.sch, power_regulation.sch]
2013-11-18 revised LED parts to match reality
    [battery_module.sch, battery_pack.sch, bike_light.sch, interface_usb.sch, micro_proc.sch, output_general.sch, output_signal_brake.sch, power_regulation.sch]
2013-11-23 fixed mosfet battery direction ic
    [battery_module.sch, battery_pack.sch, bike_light.sch, interface_usb.sch, micro_proc.sch, output_general.sch, output_signal_brake.sch, power_regulation.sch]
2013-11-24 started fleshing out USB comm circuits
    [battery_module.sch, battery_pack.sch, bike_light.sch, interface_usb.sch, micro_proc.sch, output_general.sch, output_signal_brake.sch, power_regulation.sch]
2013-11-24 added missing datasheets to old components
    [sensors_light.sch]
2013-11-24 completed USB comm circuits
    [bike_light.sch, interface_usb.sch]
2013-11-25 started working on charging IC
    can't for the life of me tell if it will work with low battery
    voltage... seems like it might work, but it won't start switching until
    the battery voltage is above 3.3V, in which case it acts as a buck
    regulator to 3.3V. That 3.3V is adjustable, however, so if we can get
    away with 3.0V on the other IC's which we need to power, we might be
    okay... It will boost the battery voltage up to 5V if a usb device is
    plugged in, but I don't think that will be useful for any of the circuit
    elements. if you get a chance, can you read over the data sheet also?
    It is a complicated device.
    [battery_charger.sch, battery_module.sch, battery_pack.sch, bike_light.sch, interface_usb.sch, micro_proc.sch, output_general.sch, output_signal_brake.sch]
2013-11-30 3.3V supply done.
    [battery_module.sch, battery_pack.sch, bike_light.sch, interface_usb.sch, micro_proc.sch, output_general.sch, output_signal_brake.sch, power_regulation.sch]
2013-11-30 save current sheet only test
    [battery_charger.sch]
2013-11-30 save whole schematic project test
    worked!
    [battery_charger.sch]
2013-11-30 deleted crap files
    [front_headlight.sch, front_signal.sch, rear_brake.sch, rear_signal.sch]
2013-11-30 added part info for power IC
2013-12-02 added MSP to proc sheet
    [battery_charger.sch, battery_module.sch, battery_pack.sch, bike_light.sch, interface_usb.sch, micro_proc.sch, output_general.sch, output_signal_brake.sch]
2013-12-05 added bat-current LED driver array for I2C
    [battery_charger.sch, battery_module.sch, battery_pack.sch, bike_light.sch, interface_usb.sch, micro_proc.sch, output_general.sch, output_signal_brake.sch]
2013-12-06 finished batt-current LED driver array over I2C
    [battery_charger.sch, battery_module.sch, battery_pack.sch, bike_light.sch, interface_usb.sch, micro_proc.sch, output_general.sch, output_signal_brake.sch]
2013-12-07 added headlight sheet, led, dac
    [battery_charger.sch, battery_module.sch, battery_pack.sch, bike_light.sch, interface_usb.sch, micro_proc.sch, output_general.sch, output_headlight.sch]
2013-12-07 organized proc sheet I/O, organized I2C bus structure
    [bike_light.sch, micro_proc.sch, sensors_light.sch]
2013-12-08 continued fleshing out proc
    [battery_charger.sch, battery_module.sch, battery_pack.sch, bike_light.sch, interface_usb.sch, micro_proc.sch, output_general.sch, output_headlight.sch]
2013-12-08 general organization, fixed power reg sheet, added jtag
    [battery_charger.sch, battery_module.sch, battery_pack.sch, bike_light.sch, interface_JTAG_2_wire.sch, interface_JTAG_2wire.sch, interface_usb.sch, micro_proc.sch]
2013-12-09 removed crap file
    [bike_light.sch, interface_JTAG_2wire.sch]
2013-12-10 2.5V Regulator finished.
    [output_signal_brake_2.sch]
2013-12-10 added thermal pad to 2.5V, added some labels
    [battery_charger.sch, battery_module.sch, battery_pack.sch, bike_light.sch, interface_JTAG_2_wire.sch, interface_usb.sch, micro_proc.sch, output_general.sch]
2013-12-11 Minor fixes, labels, etc
    [battery_charger.sch, battery_module.sch, battery_pack.sch, bike_light.sch, interface_JTAG_2_wire.sch, interface_usb.sch, micro_proc.sch, output_general.sch]
2013-12-12 started working on charging IC
    [battery_charger.sch, battery_module.sch, battery_pack.sch, bike_light.sch, interface_JTAG_2_wire.sch, interface_usb.sch, micro_proc.sch, output_general.sch]
2013-12-13 continued working on charging IC
2013-12-13 uh. same as before? some glitch
    [battery_charger.sch, battery_module.sch, battery_pack.sch, bike_light.sch, interface_JTAG_2_wire.sch, interface_usb.sch, micro_proc.sch, output_general.sch]
2013-12-14 finished schematic charger, need to part out caps and inductor
    [battery_charger.sch, battery_module.sch, battery_pack.sch, bike_light.sch, interface_JTAG_2_wire.sch, interface_usb.sch, micro_proc.sch, output_general.sch]
2013-12-18 added pullups/downs as necessary, added test pts
    also added interrupt conn to msp from charger, made led part for generic
    indicators, added generic indicators to psu's
    [battery_charger.sch, battery_module.sch, battery_pack.sch, bike_light.sch, interface_JTAG_2_wire.sch, interface_usb.sch, micro_proc.sch, output_general.sch]
2013-12-19 fixed issue with test point symbols
    [sensors_light.sch]
2013-12-20 various fixes due to issues found in ERC
    learned how to use invisible pins
    [battery_charger.sch, battery_module.sch, battery_pack.sch, bike_light.sch, interface_JTAG_2_wire.sch, interface_usb.sch, micro_proc.sch, output_general.sch]
2013-12-21 started figuring out how to get pcb going
    also need to figure out how to make some footprints, although there is a
    nice library of footprints avalible already
    [battery_charger.sch, battery_module.sch, battery_pack.sch, bike_light.sch, interface_JTAG_2_wire.sch, interface_usb.sch, micro_proc.sch, output_general.sch]
2014-01-13 gave parts unique id's
    [battery_charger.sch, battery_module.sch, battery_pack.sch, bike_light.sch, interface_JTAG_2_wire.sch, interface_usb.sch, micro_proc.sch, output_general.sch]
2014-01-18 finished making footprints!
    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
2014-01-18 placed components ... quite the task!
    there is a lot of shit going on in this board... :D
    [battery_charger.sch, battery_module.sch, battery_pack.sch, bike_light.kicad_pcb, bike_light.sch, future_use.sch, interface_JTAG_2_wire.sch, interface_usb.sch]
2014-01-19 Never thought 0805 would seem big...
    But about 80% of the space is consumed by the 0805 resistor and caps.
    01005? XD
    [bike_light.kicad_pcb]
2014-01-20 moving around parts in pcb
    [bike_light.kicad_pcb]
2014-02-01 revisions to board and sch
    [$brake_module.sch, battery_charger.sch, battery_module.sch, battery_pack.sch, bike_light.kicad_pcb, bike_light.sch, brake_leds.sch, brake_module.sch]
2014-02-01 revised layout considerably. more compact
    almost ready for routing
    [bike_light.kicad_pcb]
2014-02-03 replacement of parts, moved parts, preparing for routing
    [battery_charger.sch, battery_module.sch, battery_pack.sch, bike_light.kicad_pcb, bike_light.sch, brake_leds.sch, interface_JTAG_2_wire.sch, interface_usb.sch]
2014-02-04 organizing parts...
    [bike_light.kicad_pcb]
2014-02-07 rearranged components, revised footprints
    also planned power/gnd planes. haven't routed anything yet
    [bike_light.kicad_pcb]
2014-02-08 parts arranged plausibly
    maybe ready for routing?
    [bike_light.kicad_pcb]
2014-02-09 revised connections between boards
    now right and left will be identical and easy to assemble.
    [battery_charger.sch, battery_module.sch, battery_pack.sch, bike_light.kicad_pcb, bike_light.sch, brake_leds.sch, interface_JTAG_2_wire.sch, interface_usb.sch]
2014-02-10 began routing!!!!!
    gonna try the autorouter after important traces.
    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
    [battery_charger.sch, battery_module.sch, battery_pack.sch, bike_light.kicad_pcb, bike_light.sch, brake_leds.sch, interface_JTAG_2_wire.sch, interface_usb.sch]
2014-02-10 did 1 trace...
    [bike_light.kicad_pcb]
2014-02-13 routed 70% of board, made adjustments to schematics as necessary
    [battery_charger.sch, battery_module.sch, battery_pack.sch, bike_light.kicad_pcb, bike_light.sch, brake_leds.sch, interface_JTAG_2_wire.sch, interface_usb.sch]
2014-02-16 routed the back light module
    [battery_charger.sch, battery_module.sch, battery_pack.sch, bike_light.dsn, bike_light.kicad_pcb, bike_light.sch, brake_leds.sch, interface_JTAG_2_wire.sch]
2014-02-16 finished other light module
    [bike_light.kicad_pcb]
2014-02-17 finished routing board, added vibrator module
    [battery_charger.sch, battery_module.sch, battery_pack.sch, bike_light.kicad_pcb, bike_light.sch, brake_leds.sch, interface_JTAG_2_wire.sch, interface_usb.sch]
2014-02-22 revised board for manufacture
    still need to panelize
    [battery_charger.sch, battery_module.sch, battery_pack.sch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]
2014-02-24 made minor revisions for manufacture
    just need to panelize, double check parts, and order
    [bike_light-B_Cu.gbl, bike_light-B_Mask.gbs, bike_light-B_SilkS.gbo, bike_light-F_Cu.gtl, bike_light-F_Mask.gts, bike_light-F_SilkS.gto, bike_light-Inner_3_3V_2_5V_Cu.gbr, bike_light-Inner_GND_Cu.gbr]
2014-02-27 found error in schematic, charger stat LED
    [battery_charger.sch, battery_module.sch, battery_pack.sch, bike_light.kicad_pcb, bike_light.sch, brake_leds.sch, interface_JTAG_2_wire.sch, interface_usb.sch]
2014-03-01 added connector for testing solar panel
    [battery_charger.sch, battery_module.sch, battery_pack.sch, bike_light.kicad_pcb, bike_light.sch, brake_leds.sch, interface_JTAG_2_wire.sch, interface_usb.sch]
2014-03-01 added solar panel indicator and protection diode
    need to annotate, add parts, update netlist, and complete layout
    [interface_usb.sch]
2014-03-01 completed rev 1 of board
    need to panelize
    [battery_charger.sch, battery_module.sch, battery_pack.sch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]
2014-03-02 rearranged manufacturing file structure
    board completed for rev 1. sent out for manufacture. ordered parts.
    [bike_light-B_Cu.gbl, bike_light-B_Mask.gbs, bike_light-B_SilkS.gbo, bike_light-F_Cu.gtl, bike_light-F_Mask.gts, bike_light-F_SilkS.gto, bike_light-Inner_3_3V_2_5V_Cu.gbr, bike_light-Inner_GND_Cu.gbr]
2014-03-06 added some preview pngs of the board ^-^
2014-03-07 added note about time sync between devices
2014-03-13 wrote util adc/gpio, other minor corrections
    [util_adc.c, util_adc.h, util_gpio.c, util_gpio.h, util_i2c.c]
2014-03-15 batt_voltage sensor fleshed out
2014-03-16 started working on the timers...
2014-03-16 realized issue with timer pin out
    I don't think there is hardware support to do the RGB color control with
    indpendent duty cycles. We might have to steal one of the other LED ctrl
    outputs in order to do that, or make a hack solution in software...
    [util_timer.c]
2014-03-16 Lots of changes to main, isr, and util_adc. They all compile now. May or may not work.
    [isr.c, isr.h, main.c, main.h, util_adc.c, util_adc.h]
2014-03-17 drafted timers. problems in there though with RGB mixing
    [main.c, main.h, output_feedback_lights.c, output_feedback_lights.h, util_timer.c, util_timer.h]
2014-03-24 finished(really) the feedback LED setup
2014-03-24 implemented RGB battery fuel guage LED
2014-06-01 Added assembly files
    [BOM.xls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]
2014-06-01 Rearranged ref des for assembly outputs
    [bike_light.kicad_pcb]
2014-06-08 Added code for initial debug and testing
    All in main.c and main.h. Includes testing for the touch pads, for the
    RGB led's, and for the signal flash timer logic. Does this using the
    watchdog timer. Proc in LPM3, rest through interrupts.
2014-06-08 Added vibration debug code
    [main.c, main.h]
2014-06-08 I2C is much better looking now. Still not tested.
2014-06-14 Revert "debug code revisions attempt 2"
    This reverts commit d0ee1208265ca8849124d270e9b8d0178f3eb694.
    Conflicts:
    code/src/main.c
    [main.c]
2014-06-15 gah, reverting changes, getting ready for first run
    [main.c]
2014-06-15 started debugging, fixed project file
    [main.c, main.h]
2014-06-16 New: Touch, debug LED's, clicker, wdt interval
    minimally functional demo of touch enabled signaling, using wdt timer as
    the means for switching a debug LED on and off. click feedback enabled
    through buzzer. interrupt driven LPM3.
    [main.c, main.h]
2014-06-16 SAM- HELP? added various I2C debug stuff
    need help using some of your functions
2014-06-17 still not working... ptrs- oh my.
    [main.c, util_i2c.h]
2014-06-17 Quick fixes to i2c debug code to fix datatypes.
    [main.c, util_i2c.c, util_i2c.h]
2014-06-18 small changes. still compilation issues.
    something related to argument types within the functions in i2c.c I
    didn't get much of a chance to debug today, so I can check tomorrow
    [main.c, util_i2c.c, util_i2c.h]
2014-06-18 data type conflicts resolved. compiles, but...
    USCIAB0TX interrupt is never firing. Need to do some digging and figure
    out why.
    [main.c, util_i2c.c, util_i2c.h]
2014-06-21 added i2c all call for light demo
2014-06-21 update util i2c
2014-06-22 I2C - BROKEN...
    gets stuck in an infinite loop where the write function gets called over
    and over. If I single step then everything works as intended. If I let
    the chip run, then the I2C LED's never turn on. The older code worked,
    but I don't like the way it was written. It really needs to be
    non-blocking.
    [main.c, util_i2c.c, util_i2c.h]
2014-06-24 I2C Write demo w/ I2C LED's
    Works with older code (committed here). Trying to figure out why my new
    code (commented - which I think is cleaner) doesn't work. Problem with
    writing has been isolated to I2C ISR. Also, figured out that the way to
    turn the LED's on and off is with their LEDMODE bits, rather than by
    turning on/off the MODE1 oscillator bit. The latter results in glitches
    during operation.
    [main.c, util_i2c.c]
2014-06-25 I2C Write - works. Set Slave Adr - works.
    working on read command now.
2014-06-25 problems with I2C read...
    needs revising
    [main.c, util_i2c.c]
2014-06-26 I2C Write/Read single/multi works.
    Added some code for demo in main.
2014-06-26 started interfacing with charger IC
    defines moved to chip~.h, filled in battery info and charger info, just
    need to write the commands using i2c functions
2014-06-26 finished comms w/ led drivers
    added chip~.c,.h files for led drivers, updated project file, added
    minimal demos for chip comms, updated i2c files
2014-06-29 finished light sense comms
    also modified adc.c isr
2014-06-29 added accel isr
    I guess the port 2 isr should be in main or in its own file, as it
    shares interrupts from the charger, the accel, and the touch inputs?
2014-06-29 started fleshing in UART comms
2014-06-30 finalized UART comms
    isrs need to be implemented externally so that I2C and UART can share
    the same ISRs
2014-07-01 debugging accel comm.
    Interrupts not firing, hangs with bus low. Seemed to work initially, but
    have since been unsuccessful in reliably communicating.
2014-07-04 No adc! Problems with accel and light sens
    [chip_BH1620FVC.c, chip_MMA7660FC.c, main.c]
